PnMagalhaes/Levitation-Ball/Galery/IMG_20170502_105831.jpg

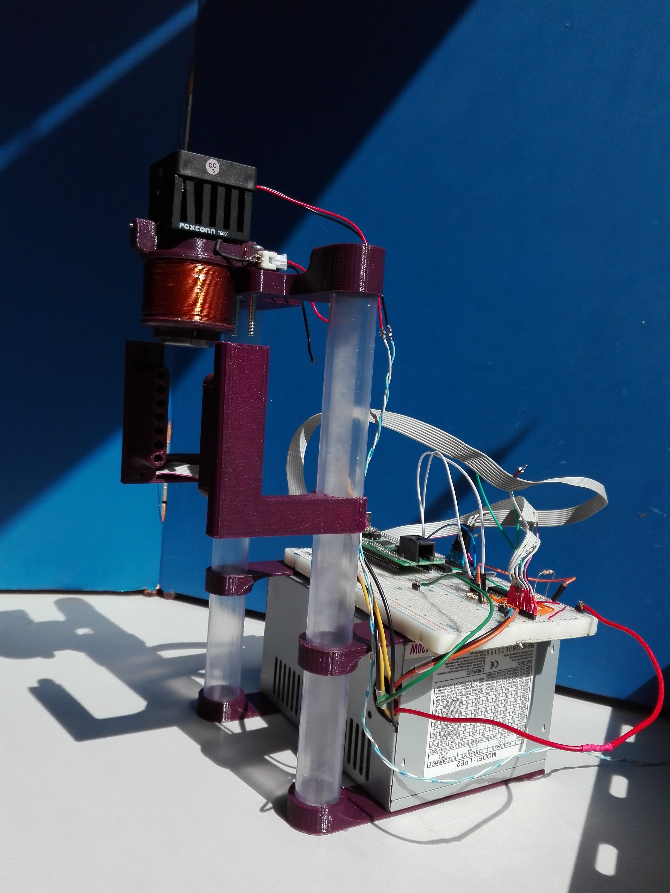
Galery/IMG_20170502_105831.jpg
