PnMagalhaes/Levitation-Ball/Galery/IMG_20170501_231723.jpg

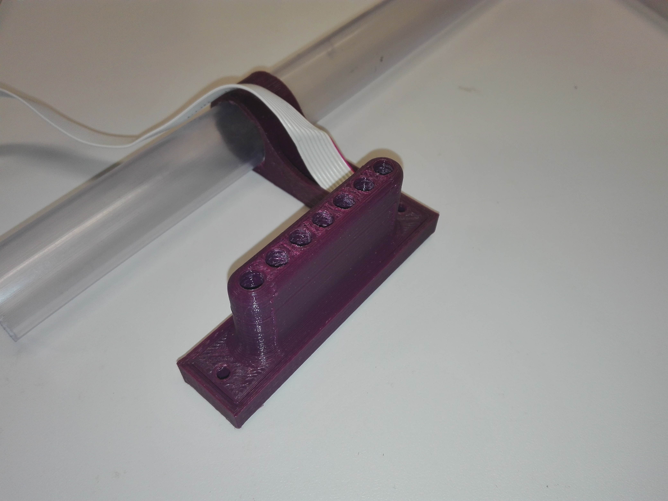
Galery/IMG_20170501_231723.jpg
