PnMagalhaes/Levitation-Ball/Circuits/Regulador/LinksImportantes.docx

http://photonics.engr.uga.edu/controls/levitator_assignment.pdf

http://web.mit.edu/6.302/www/maglev.pdf

https://mekonik.wordpress.com/2009/03/17/arduino-magnet-levitation/

http://www.onmyphd.com/?p=voltage.regulators.linear.series
