PnMagalhaes/Levitation-Ball/Circuits/Regulador/ChargePump.PNG

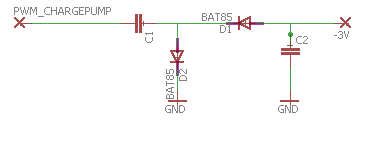
Circuits/Regulador/ChargePump.PNG
