PnMagalhaes/Levitation-Ball/Circuits/Regulador/weird stuff.JPG

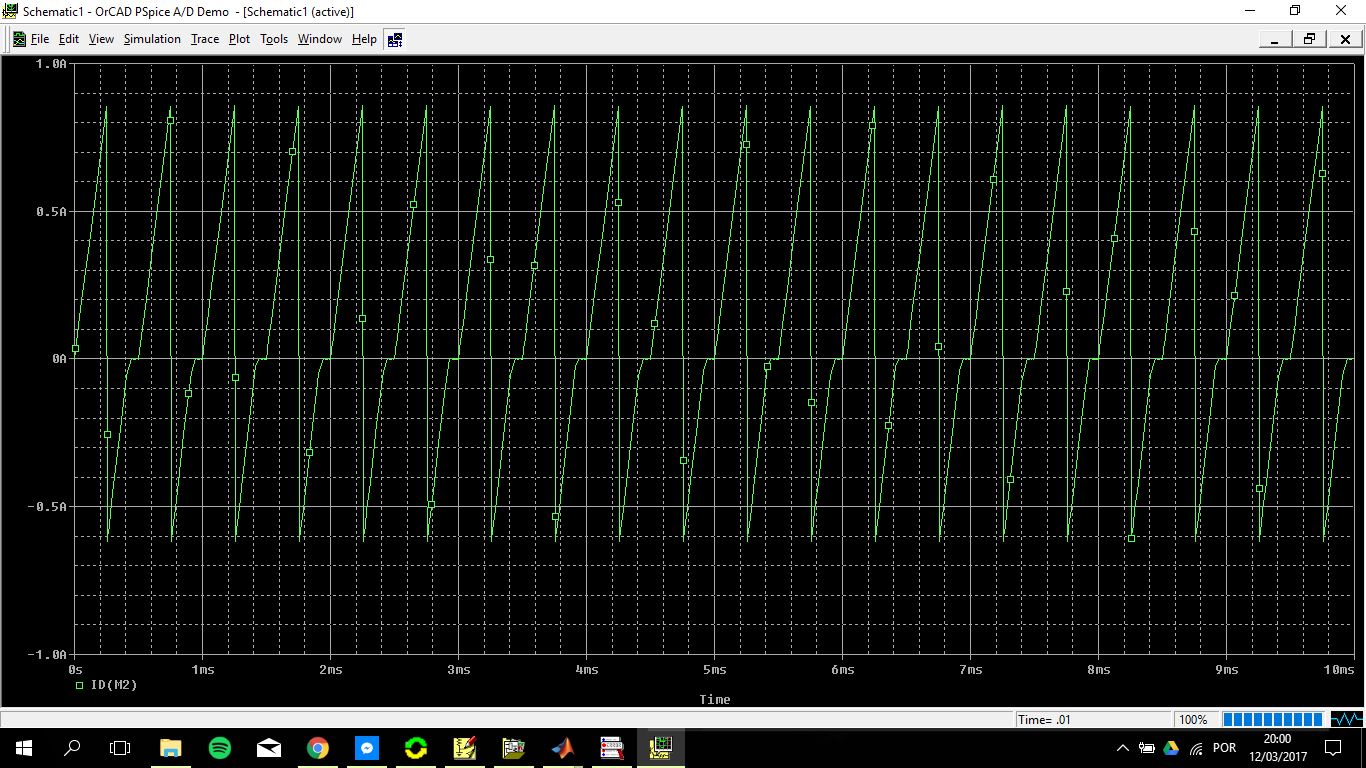
Circuits/Regulador/weird stuff.JPG
