PnMagalhaes/Levitation-Ball/Circuits/Sensores/emissoresIR.PNG

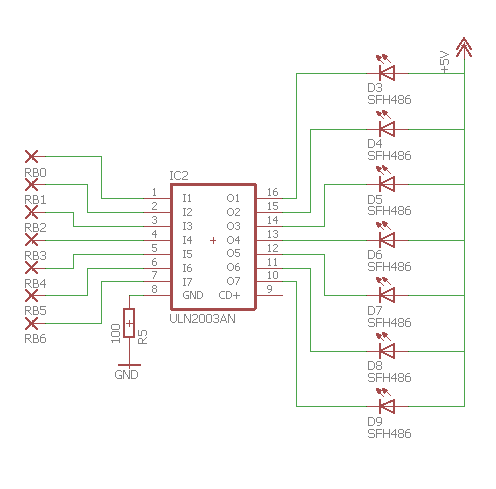
Circuits/Sensores/emissoresIR.PNG
