PnMagalhaes/Levitation-Ball/Documentation/PERT Diagram Example 1 - New Page.png

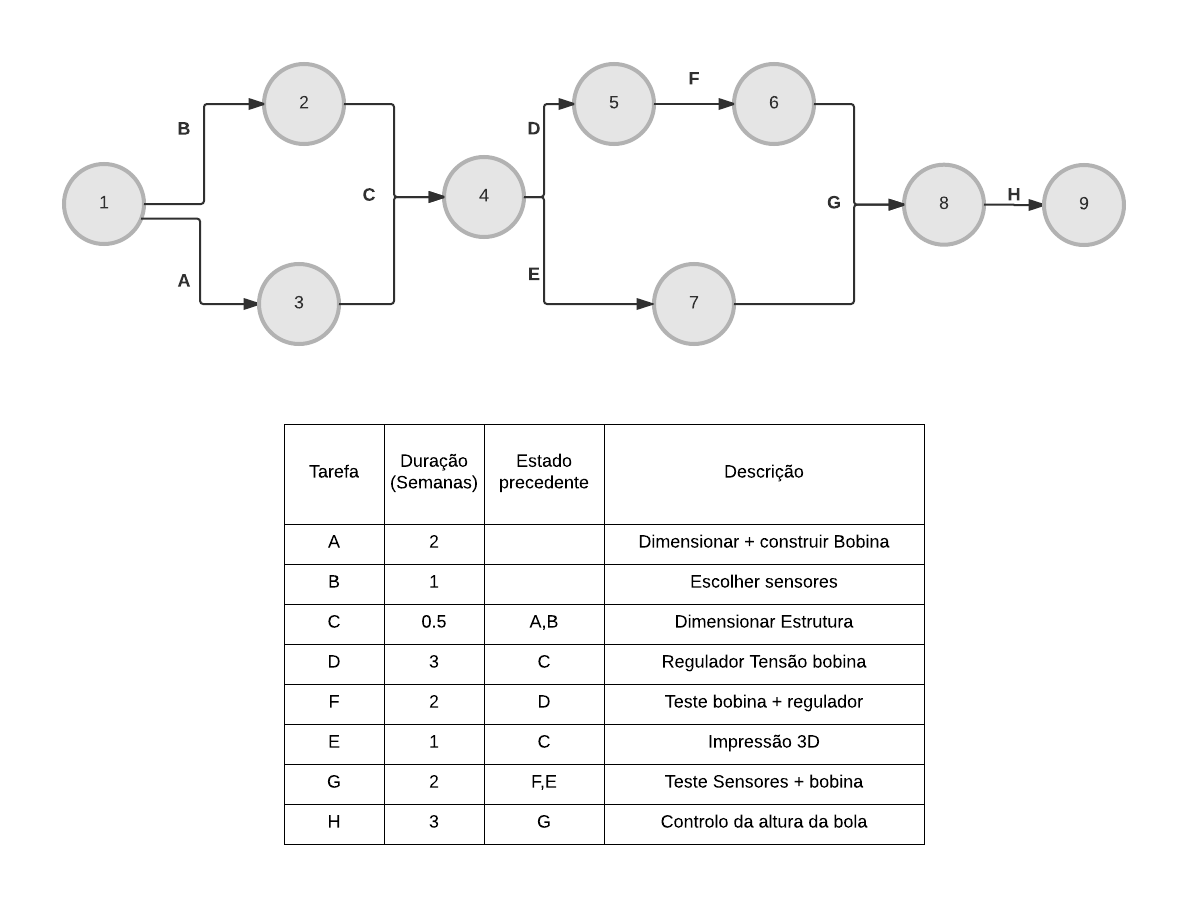
Documentation/PERT Diagram Example 1 - New Page.png
