PnMagalhaes/Levitation-Ball/Galery/20170320_143558.jpg

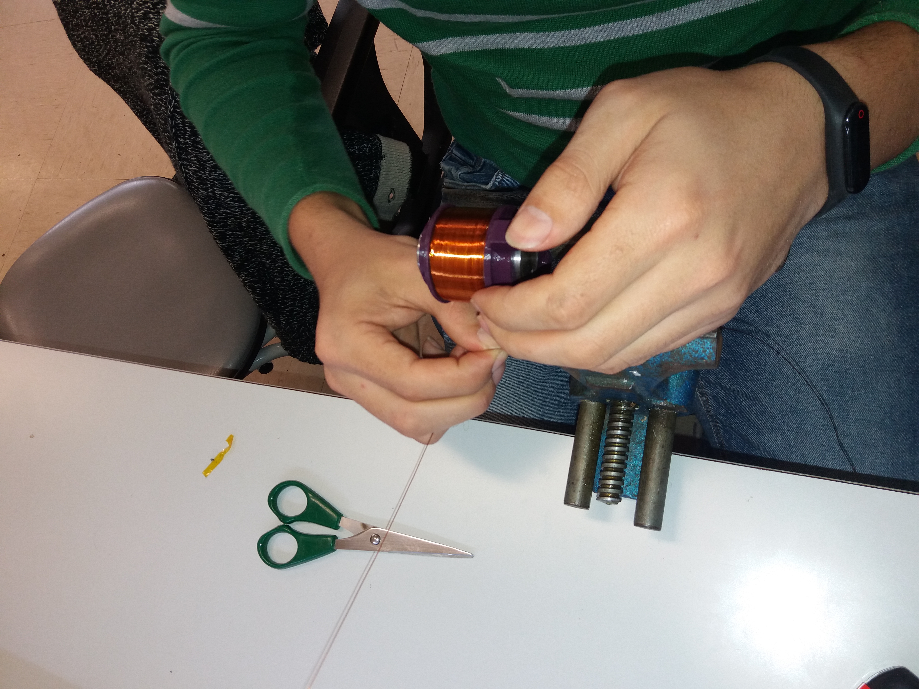
Galery/20170320_143558.jpg
