PnMagalhaes/Levitation-Ball/Galery/20170320_180035.jpg

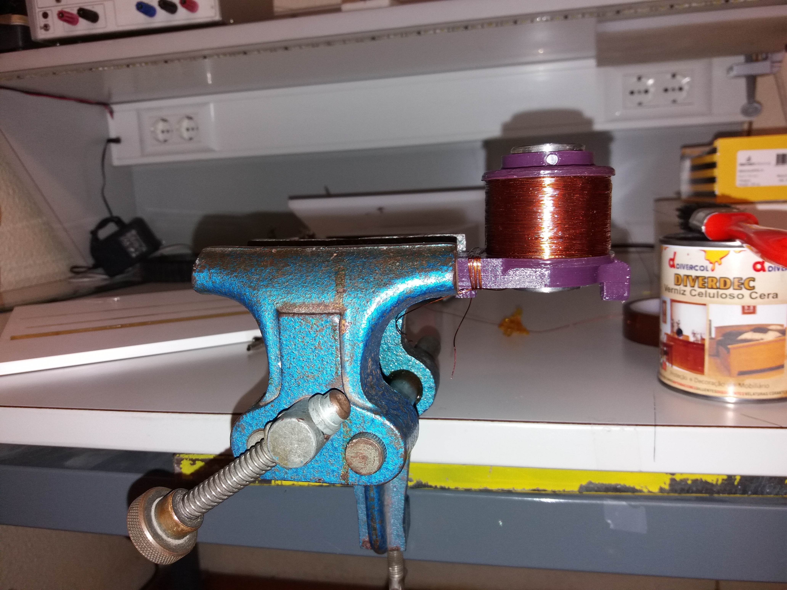
Galery/20170320_180035.jpg
