PnMagalhaes/Levitation-Ball/Galery/IMG_20170501_231756.jpg

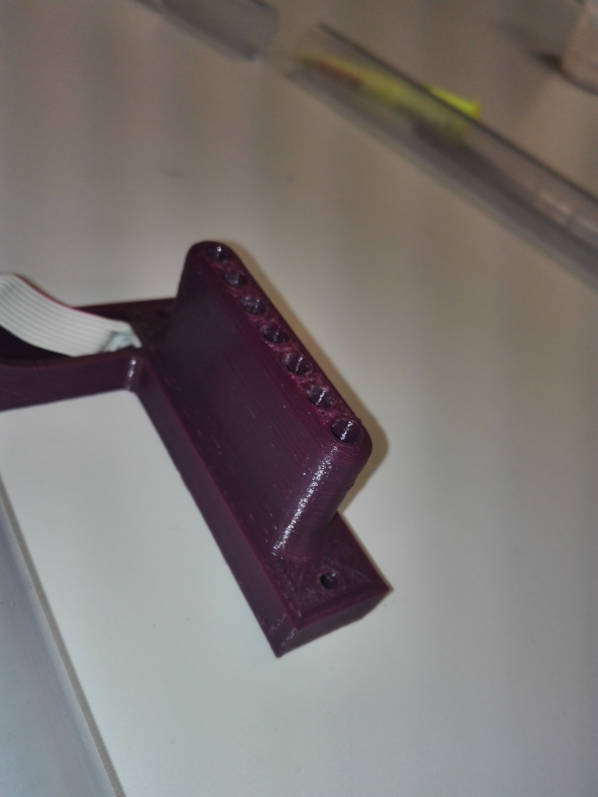
Galery/IMG_20170501_231756.jpg
