PnMagalhaes/Levitation-Ball/Galery/IMG_20170501_232402.jpg

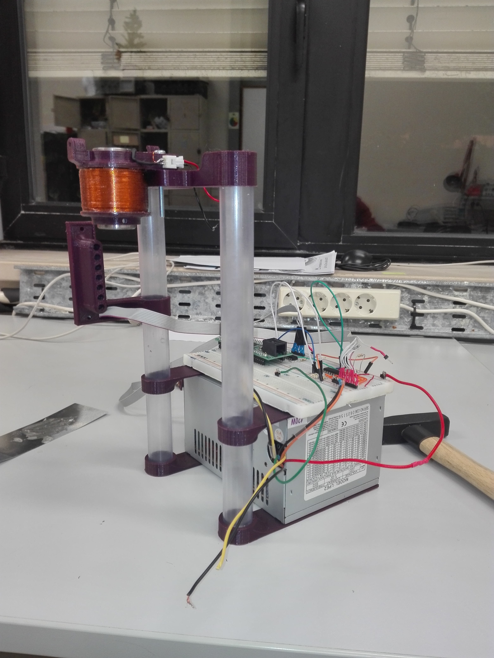
Galery/IMG_20170501_232402.jpg
