PnMagalhaes/Levitation-Ball/Galery/IMG_20170501_232730.jpg

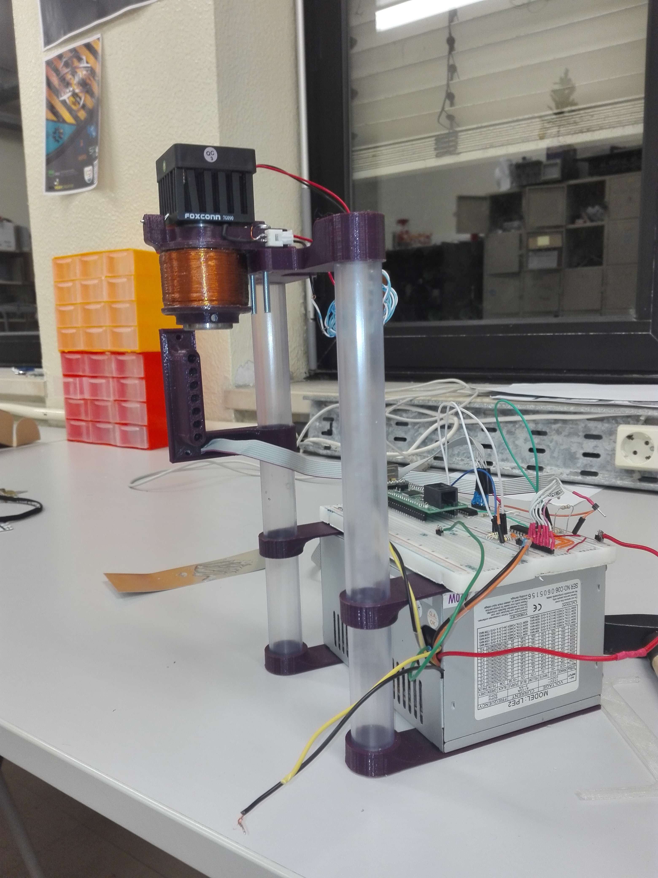
Galery/IMG_20170501_232730.jpg
