PnMagalhaes/Levitation-Ball/Galery/IMG_20170502_105451.jpg

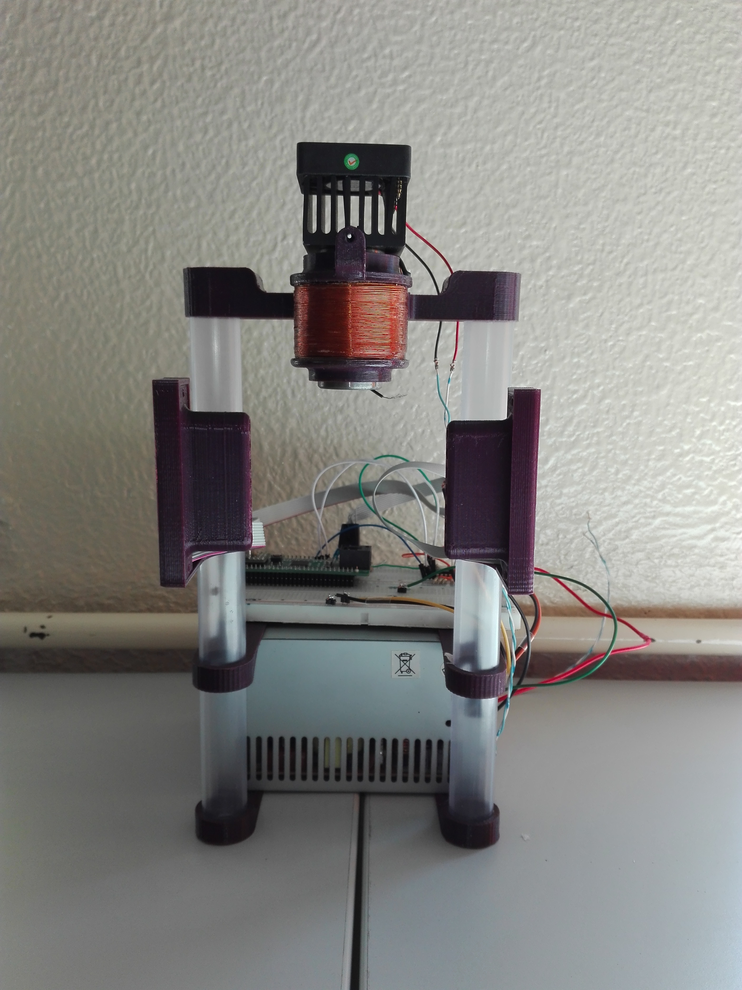
Galery/IMG_20170502_105451.jpg
