PnMagalhaes/Levitation-Ball/Galery/IMG_20170502_105531.jpg

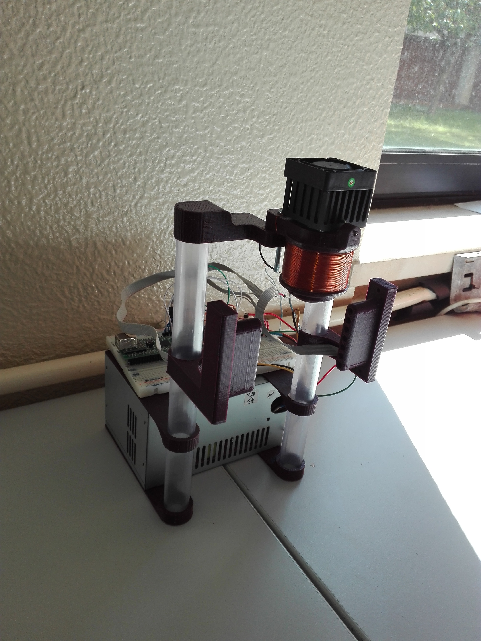
Galery/IMG_20170502_105531.jpg
