PnMagalhaes/Levitation-Ball/Galery/IMG_20170502_105553.jpg

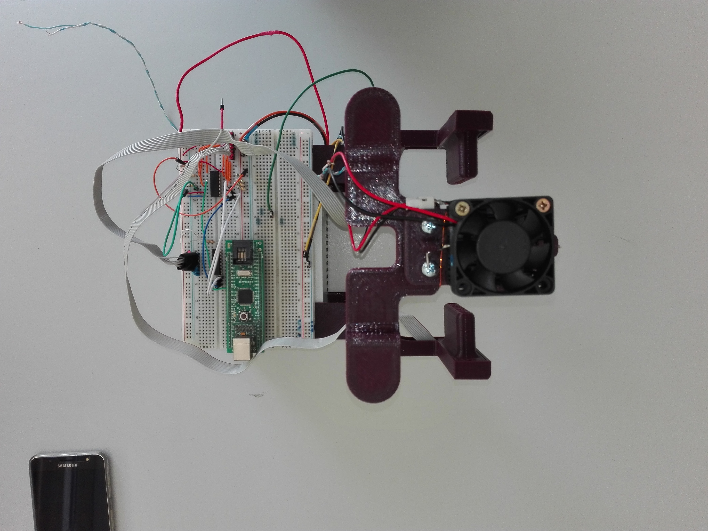
Galery/IMG_20170502_105553.jpg
