PnMagalhaes/Levitation-Ball/Galery/IMG_20170502_105650.jpg

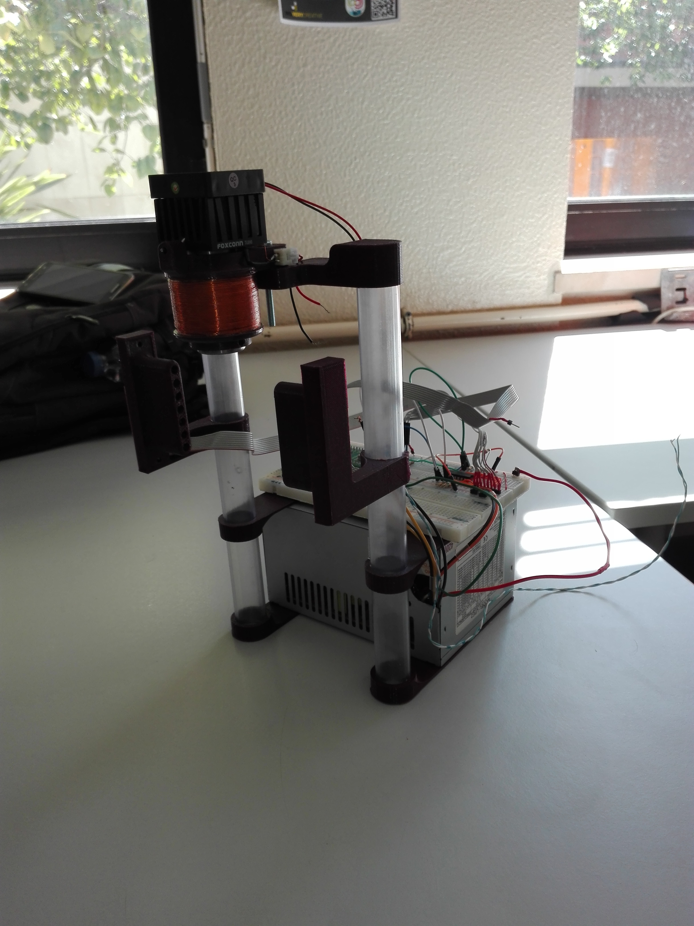
Galery/IMG_20170502_105650.jpg
