PnMagalhaes/Levitation-Ball/Galery/IMG_20170502_105702.jpg

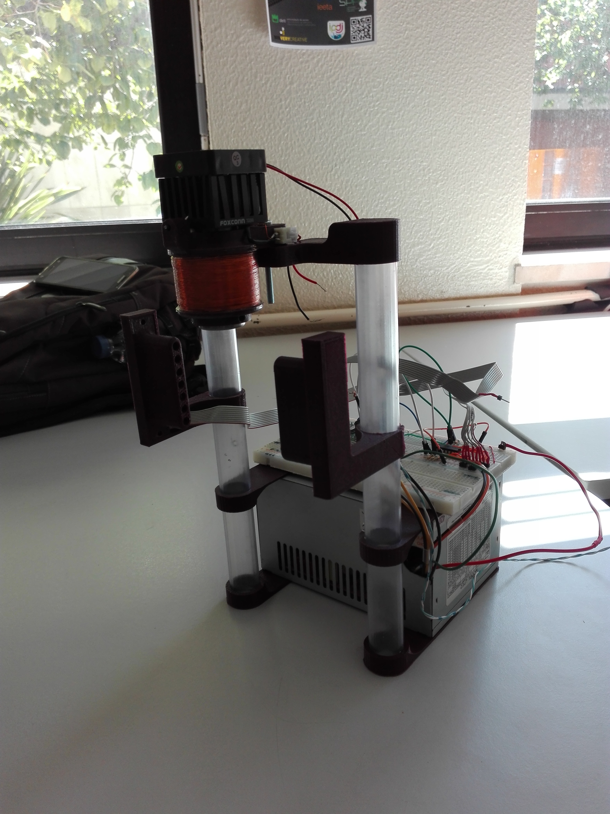
Galery/IMG_20170502_105702.jpg
