PnMagalhaes/Levitation-Ball/Simulation/EMS SW/New folder/Assem3.SLDASM

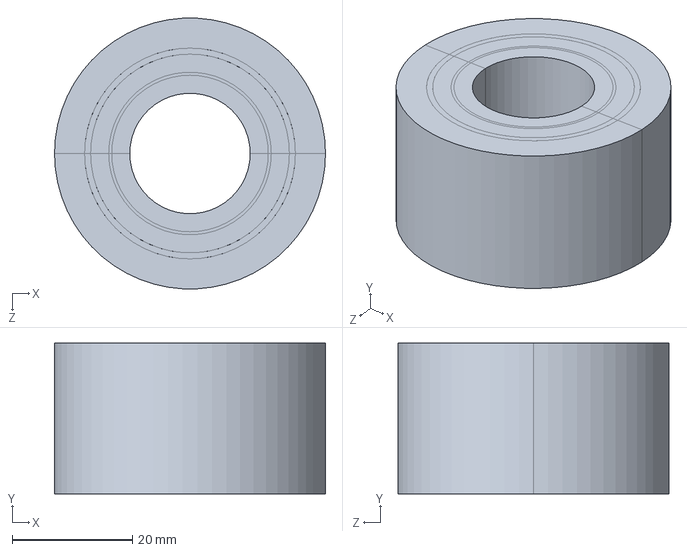
[picture p33: CAD file, 2017-05-07]
Simulation/EMS SW/New folder/Assem3.SLDASM
45.0 x 25.0 x 44.9 mm
partBobina x 2
