PnMagalhaes/Levitation-Ball/Simulation/EMS SW/half/Assem1.SLDASM

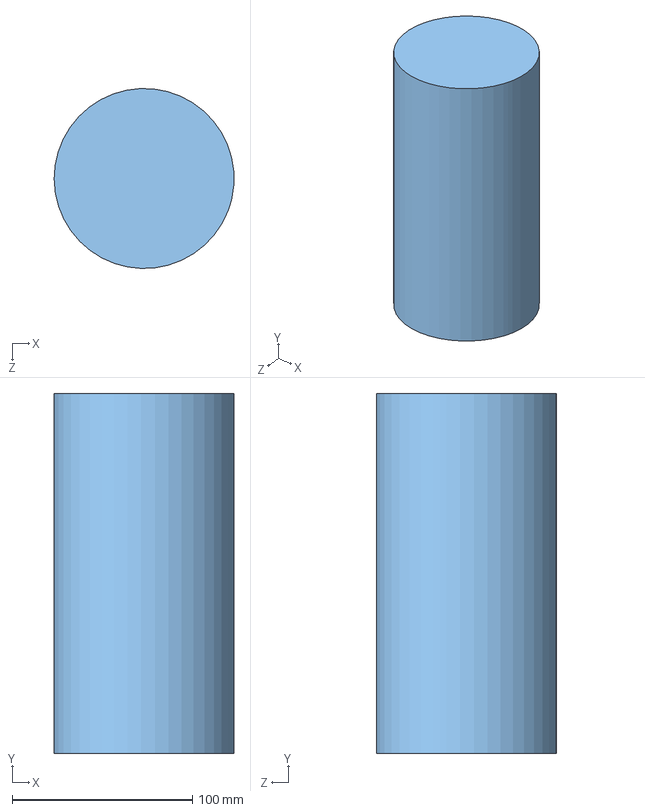
[picture p34: CAD file, 2017-05-07]
Simulation/EMS SW/half/Assem1.SLDASM
99.9 x 200.0 x 99.9 mm
coil
Nucleo
mass
arGap
