PnMagalhaes/Levitation-Ball/Simulation/EMS SW/New folder/Assem2.SLDASM

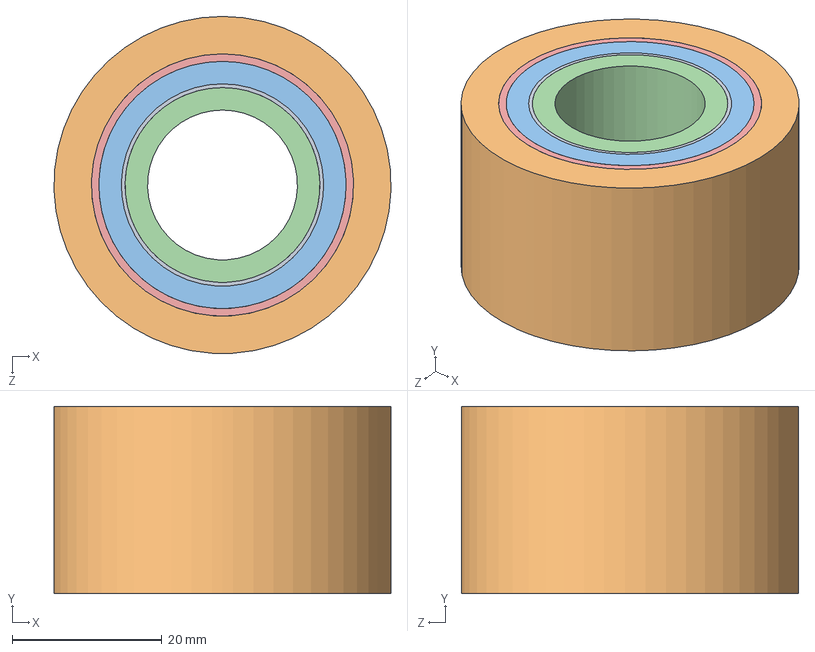
[picture p35: CAD file, 2017-05-07]
Simulation/EMS SW/New folder/Assem2.SLDASM
45.0 x 25.0 x 45.0 mm
A1
c3
c2
c1
a2
