PnMagalhaes/Levitation-Ball/3D models/SolidWorks/Assem2.SLDASM

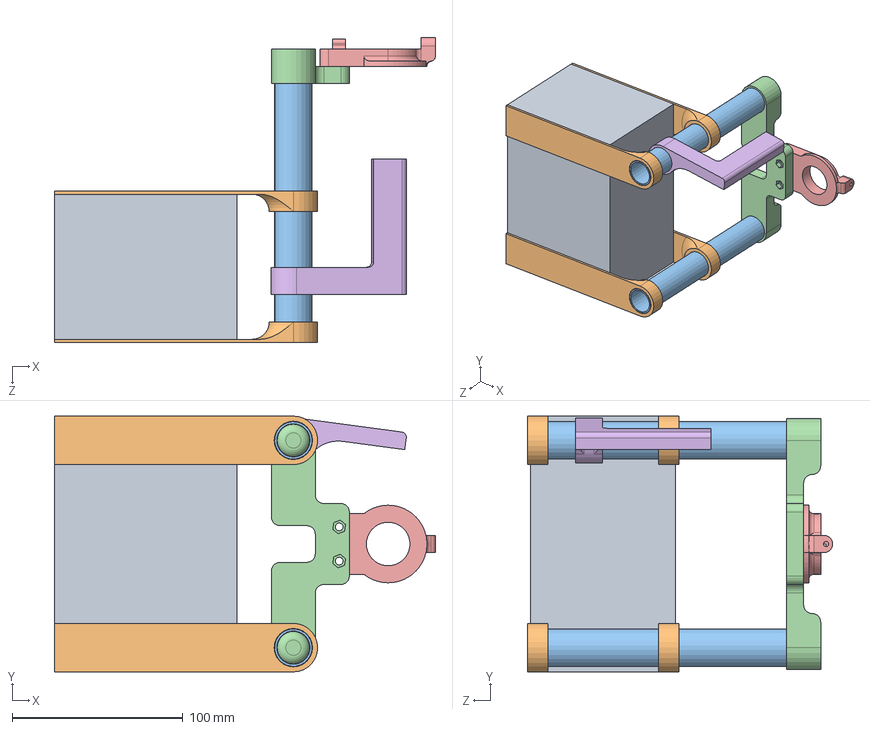
[picture p36: CAD file, 2017-05-07]
3D models/SolidWorks/Assem2.SLDASM
223.3 x 150.0 x 179.0 mm
fonte
Patinha x 4
tubo x 2
top
Dissipador
sensores2
