PnMagalhaes/Levitation-Ball/Simulation/EMS SW/half/Assem2.SLDASM

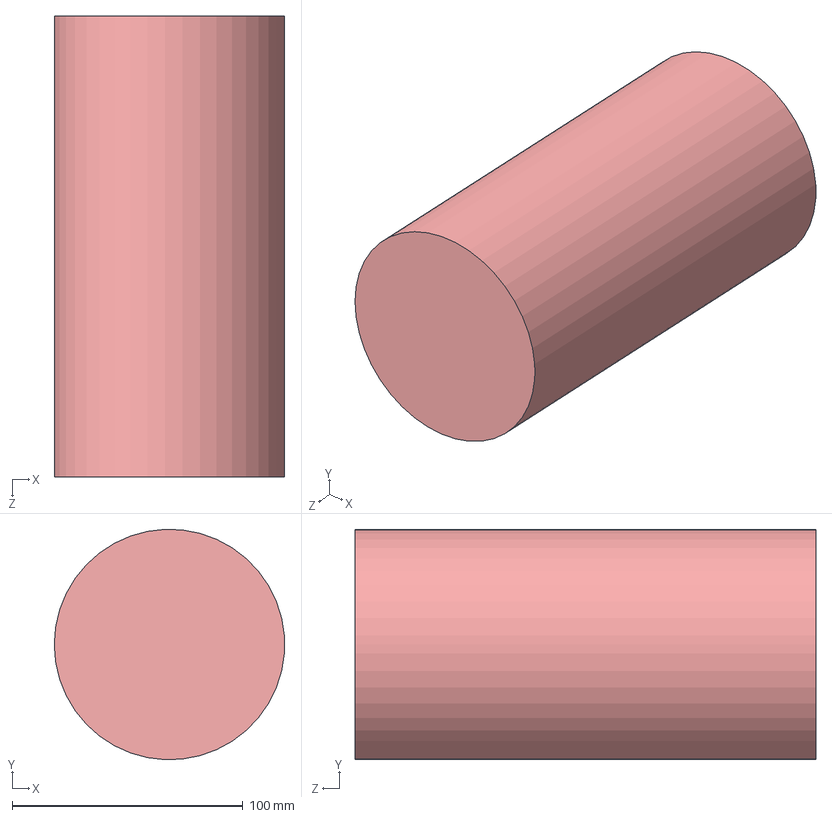
[picture p37: CAD file, 2017-05-07]
Simulation/EMS SW/half/Assem2.SLDASM
100.0 x 99.9 x 200.0 mm
coilh
arGap
mass
Nucleo
