PnMagalhaes/Levitation-Ball/Simulation/EMS SW/Assem4.SLDASM

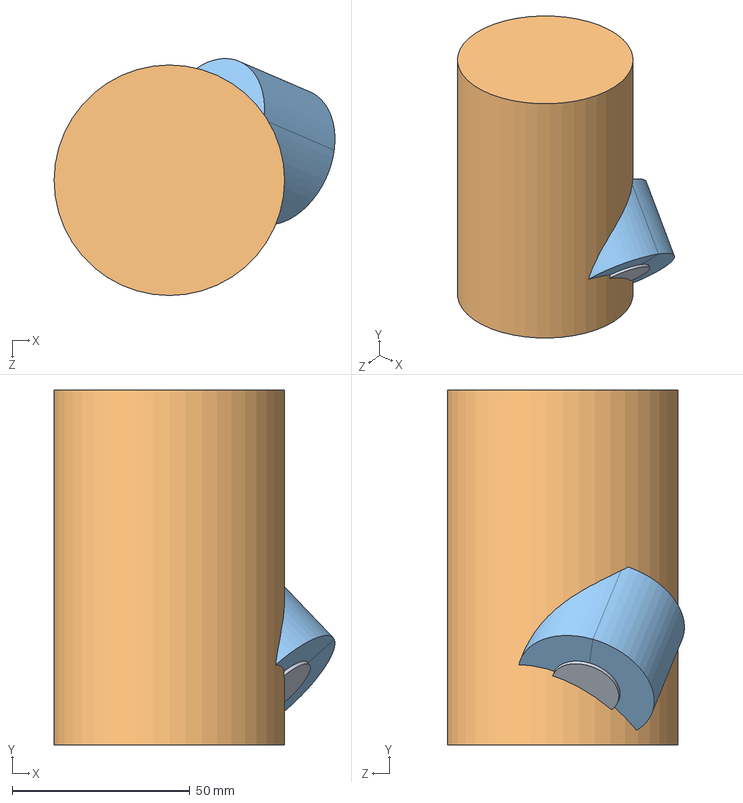
[picture p38: CAD file, 2017-05-07]
Simulation/EMS SW/Assem4.SLDASM
79.1 x 100.0 x 66.8 mm
Nucleo
coil
in_Air
