PnMagalhaes/Levitation-Ball/Simulation/EMS SW/Assem3.SLDASM

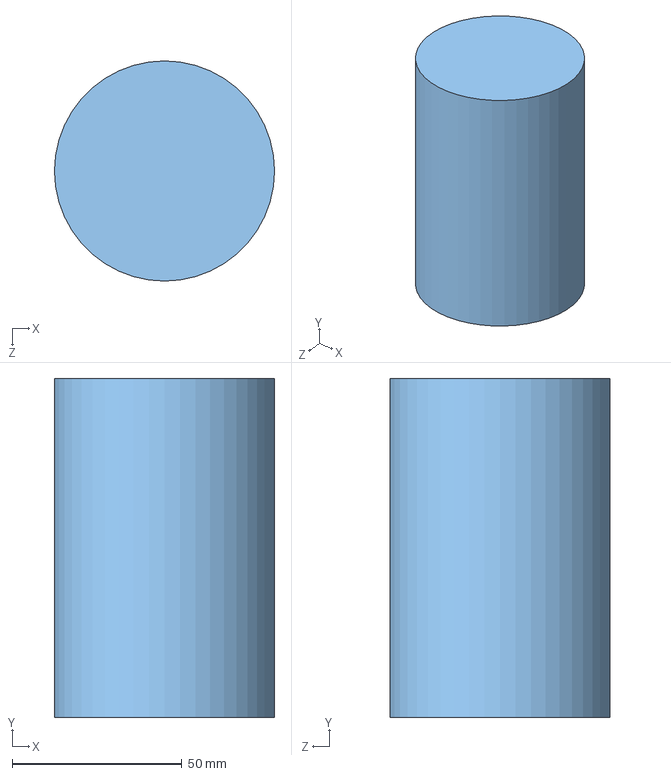
[picture p39: CAD file, 2017-05-07]
Simulation/EMS SW/Assem3.SLDASM
64.9 x 100.0 x 64.9 mm
coil
Nucleo
