PnMagalhaes/Levitation-Ball/Simulation/EMS SW/Assem2.SLDASM

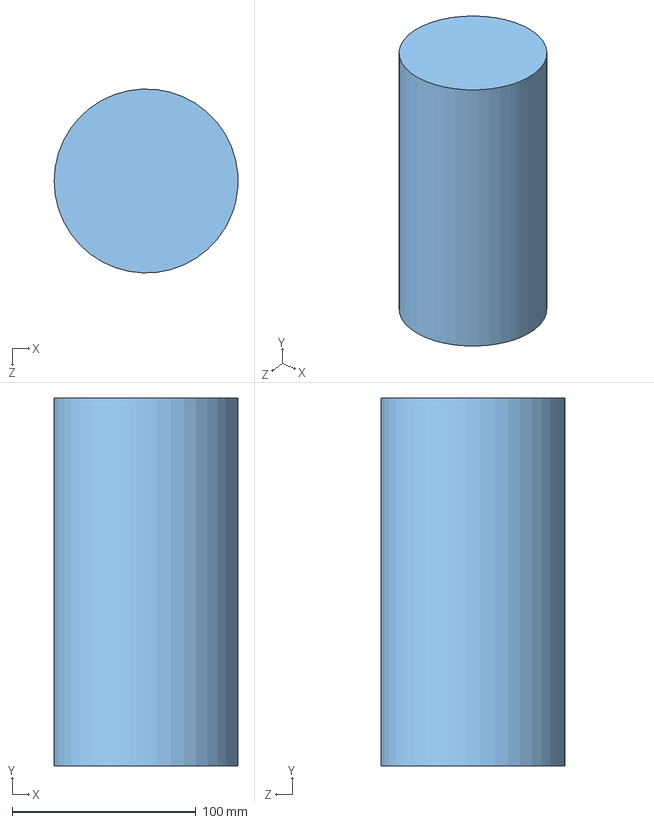
[picture p40: CAD file, 2017-05-07]
Simulation/EMS SW/Assem2.SLDASM
99.9 x 200.0 x 99.9 mm
coil
Nucleo
in_Air
