PnMagalhaes/Levitation-Ball/3D models/SolidWorks/anilha_baixo.SLDPRT

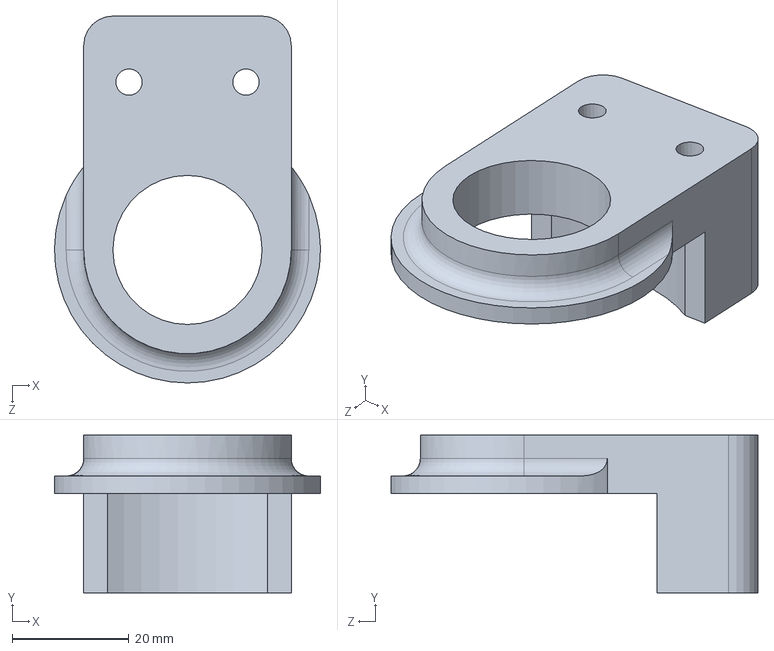
[picture p41: CAD file, 2017-05-09]
3D models/SolidWorks/anilha_baixo.SLDPRT
45.5 x 27.0 x 62.8 mm
