PnMagalhaes/Levitation-Ball/Simulation/EMS SW/half/coilh.SLDPRT

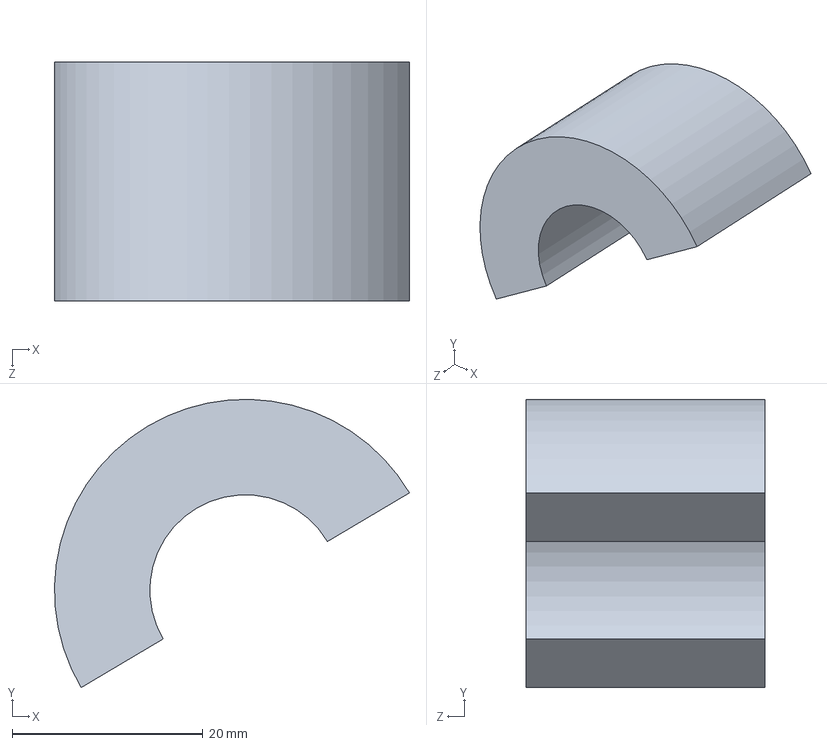
[picture p42: CAD file, 2017-05-07]
Simulation/EMS SW/half/coilh.SLDPRT
37.2 x 30.2 x 25.0 mm
