PnMagalhaes/Levitation-Ball/Simulation/EMS SW/New folder/A1.SLDPRT

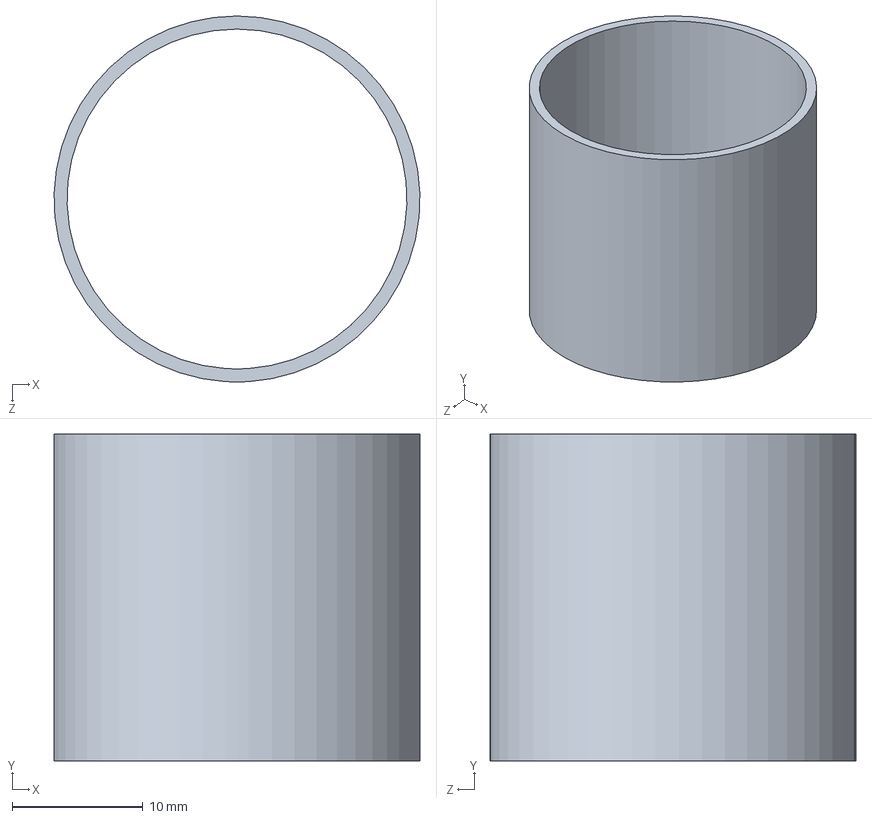
[picture p43: CAD file, 2017-05-07]
Simulation/EMS SW/New folder/A1.SLDPRT
28.0 x 25.0 x 28.0 mm
