PnMagalhaes/Levitation-Ball/Simulation/EMS SW/tape4.SLDPRT

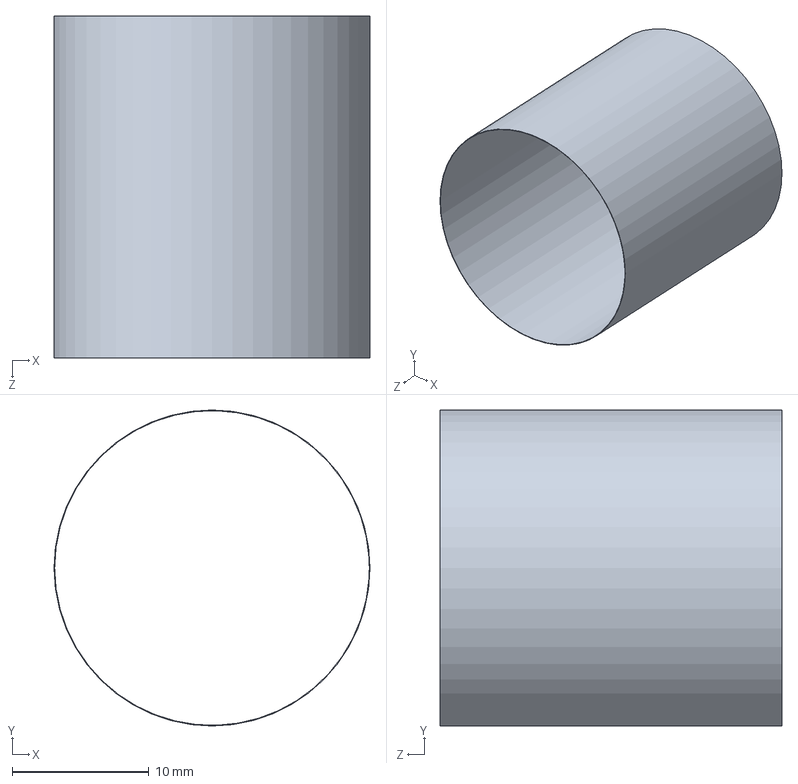
[picture p44: CAD file, 2017-05-07]
Simulation/EMS SW/tape4.SLDPRT
23.1 x 23.1 x 25.0 mm
