PnMagalhaes/Levitation-Ball/3D models/SolidWorks/sensores2.SLDPRT

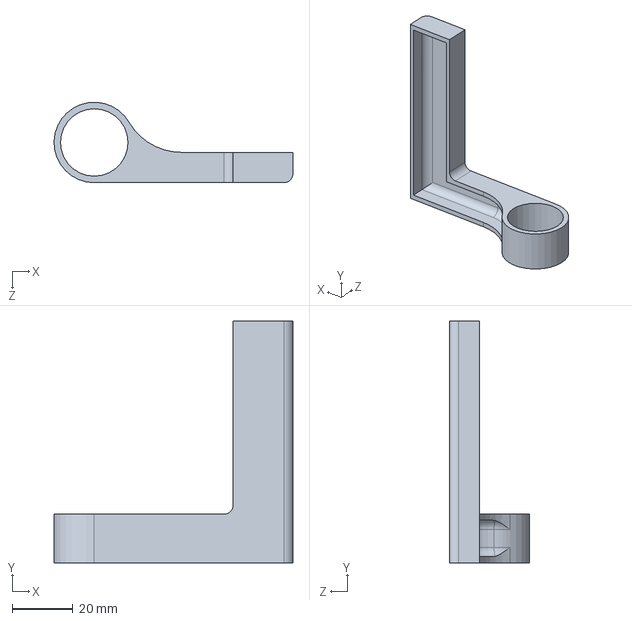
[picture p45: CAD file, 2017-05-07]
3D models/SolidWorks/sensores2.SLDPRT
78.7 x 79.5 x 26.5 mm
