PnMagalhaes/Levitation-Ball/3D models/STL-To print/top.STL

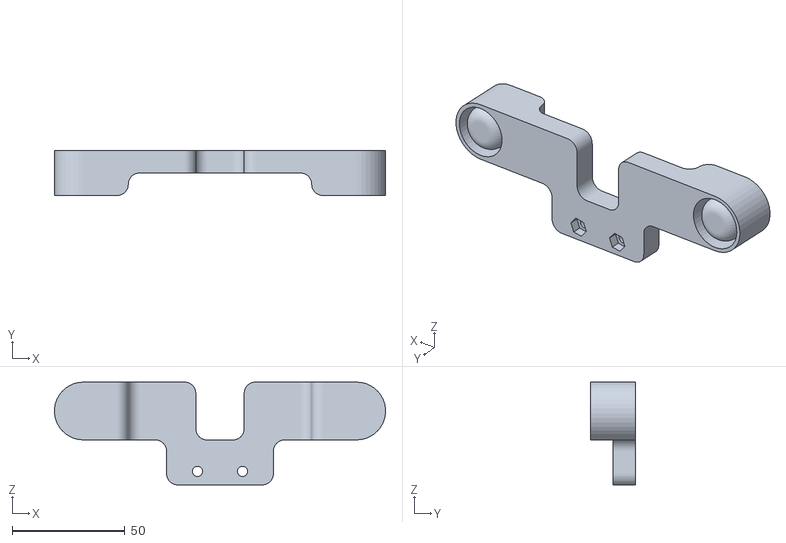
[picture p46: CAD file, 2017-05-07]
3D models/STL-To print/top.STL
147.1 x 20.0 x 45.7
