PnMagalhaes/Levitation-Ball/Simulation/EMS SW/half/arGap.SLDPRT

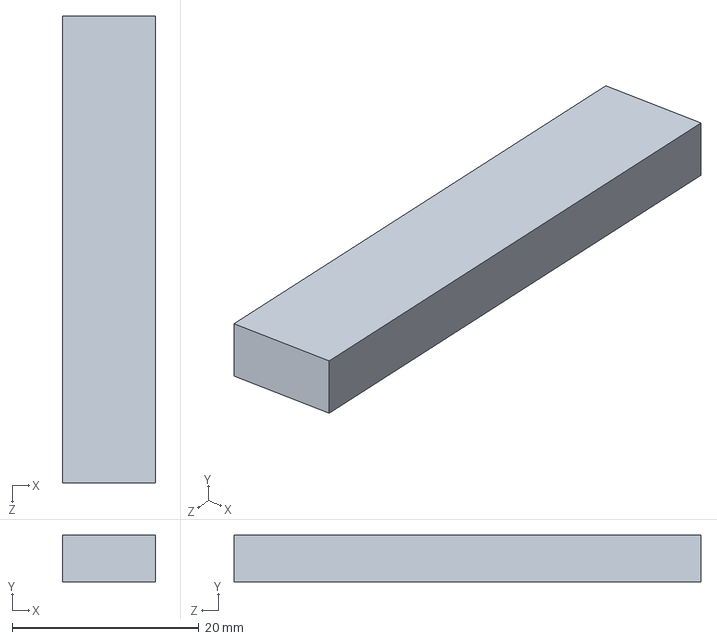
[picture p47: CAD file, 2017-05-07]
Simulation/EMS SW/half/arGap.SLDPRT
10.0 x 5.00 x 50.0 mm
