PnMagalhaes/Levitation-Ball/Simulation/EMS SW/tape6.SLDPRT

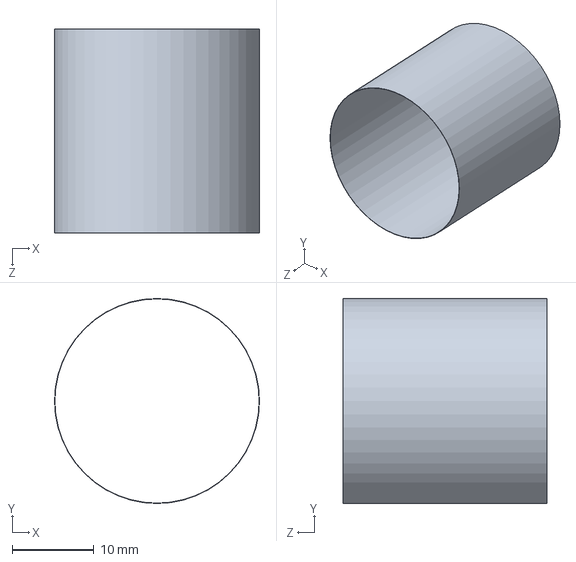
[picture p48: CAD file, 2017-05-07]
Simulation/EMS SW/tape6.SLDPRT
25.1 x 25.1 x 25.0 mm
