PnMagalhaes/Levitation-Ball/3D models/STL-To print/Patinha.STL

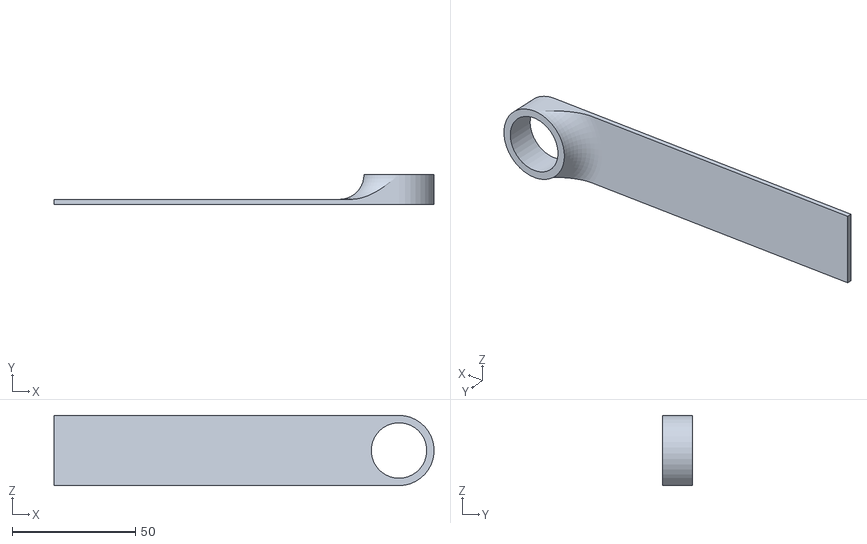
[picture p49: CAD file, 2017-05-07]
3D models/STL-To print/Patinha.STL
154.2 x 12.0 x 28.5
