PnMagalhaes/Levitation-Ball/Simulation/EMS SW/New folder/partBobina.SLDPRT

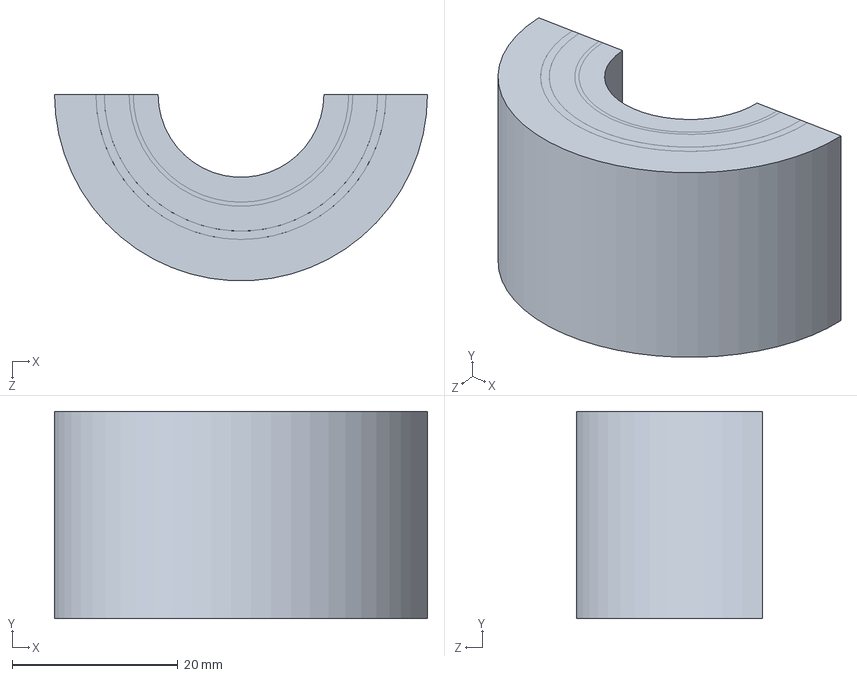
[picture p50: CAD file, 2017-05-07]
Simulation/EMS SW/New folder/partBobina.SLDPRT
45.0 x 25.0 x 22.5 mm
