PnMagalhaes/Levitation-Ball/Simulation/EMS SW/tape10.SLDPRT

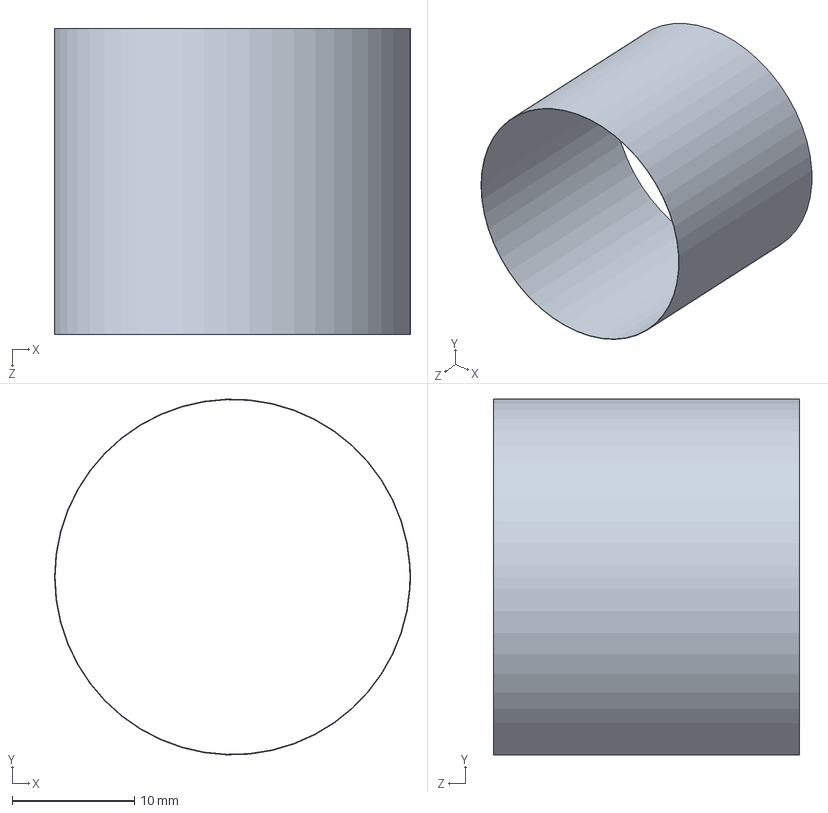
[picture p51: CAD file, 2017-05-07]
Simulation/EMS SW/tape10.SLDPRT
29.1 x 29.1 x 25.0 mm
