PnMagalhaes/Levitation-Ball/Simulation/EMS SW/coil.SLDPRT

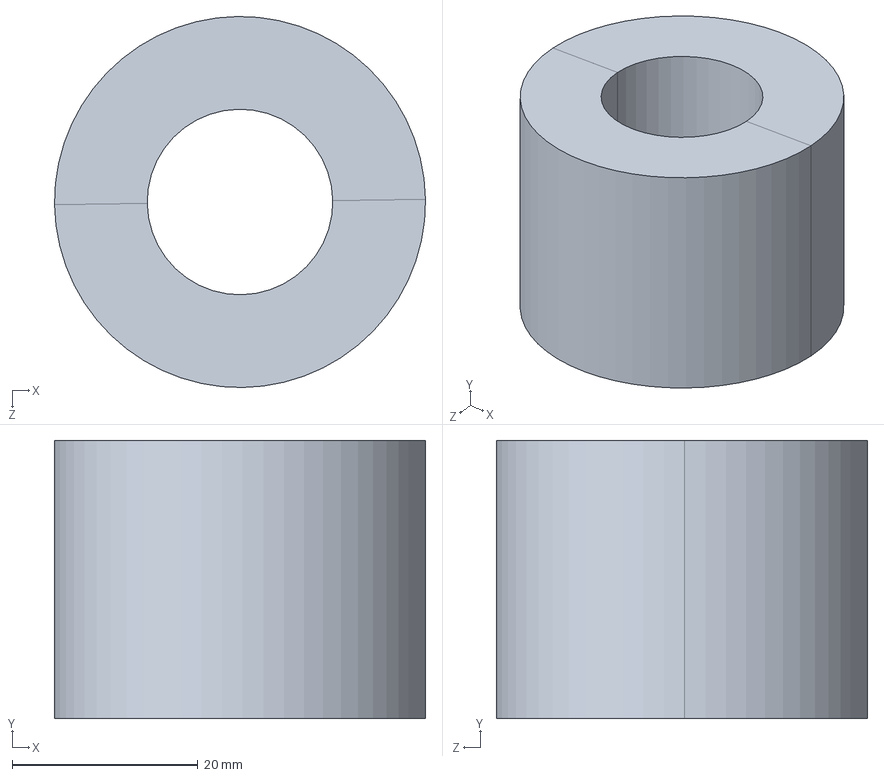
[picture p52: CAD file, 2017-05-07]
Simulation/EMS SW/coil.SLDPRT
40.0 x 30.0 x 40.0 mm
