PnMagalhaes/Levitation-Ball/Simulation/EMS SW/half/Nucleo.SLDPRT

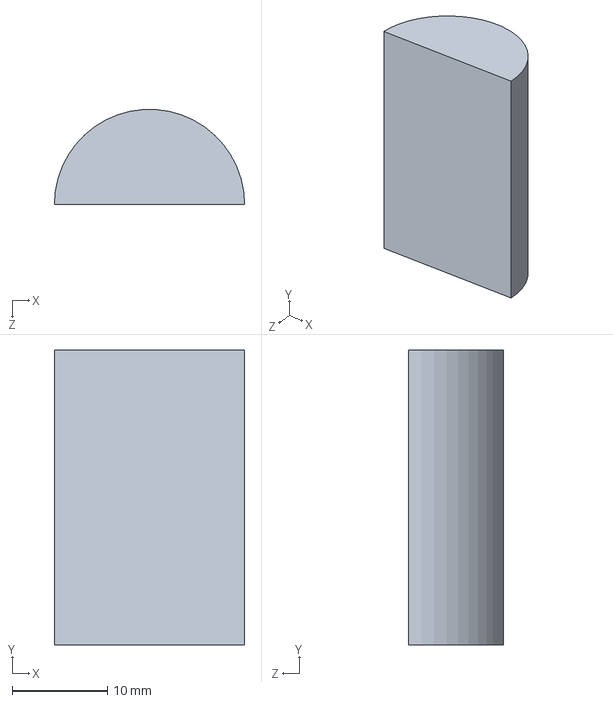
[picture p53: CAD file, 2017-05-07]
Simulation/EMS SW/half/Nucleo.SLDPRT
20.0 x 31.0 x 9.98 mm
