PnMagalhaes/Levitation-Ball/Simulation/EMS SW/mass.SLDPRT

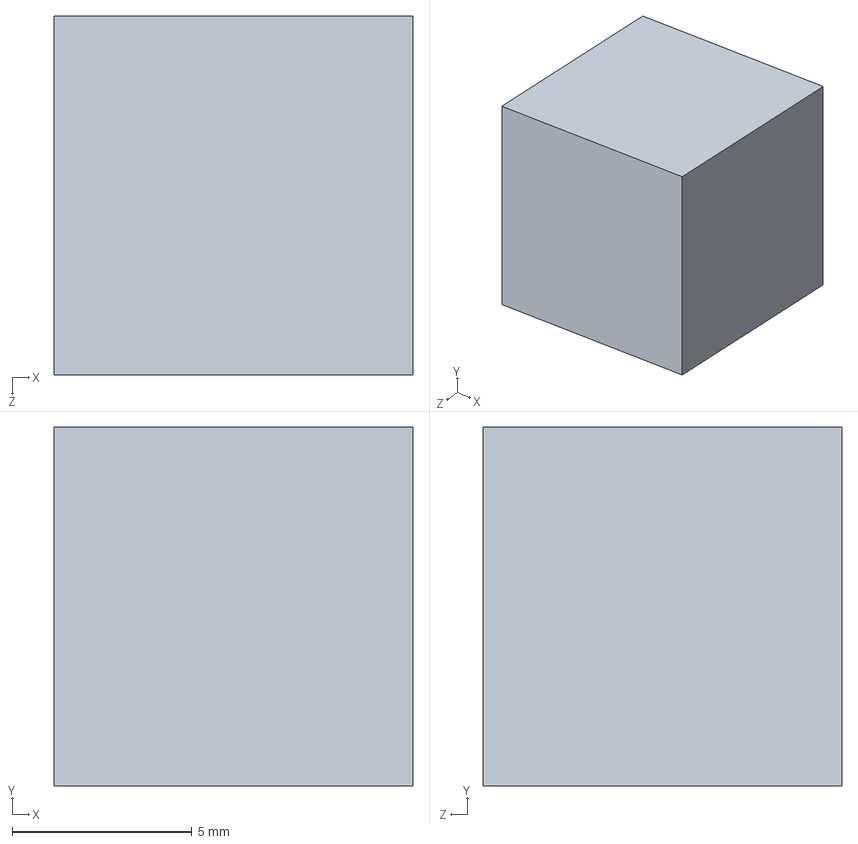
[picture p54: CAD file, 2017-05-07]
Simulation/EMS SW/mass.SLDPRT
10.0 x 10.0 x 10.0 mm
