PnMagalhaes/Levitation-Ball/Simulation/EMS SW/New folder/a2.SLDPRT

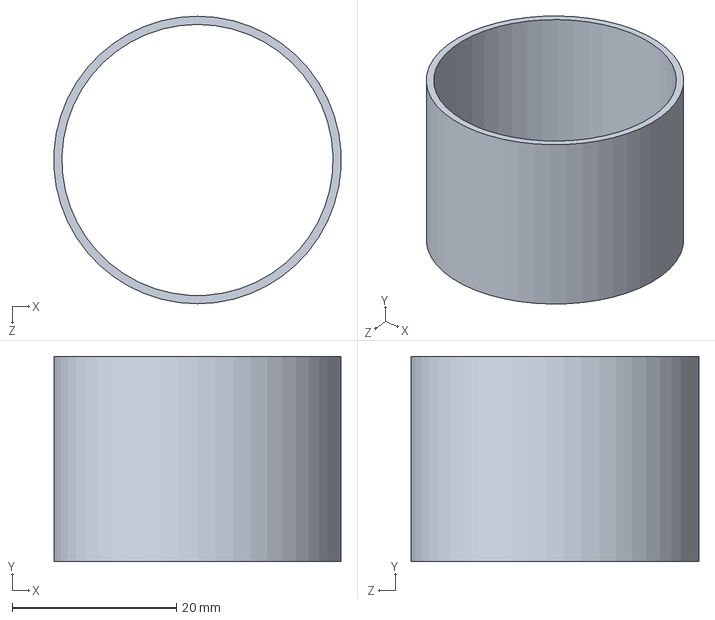
[picture p55: CAD file, 2017-05-07]
Simulation/EMS SW/New folder/a2.SLDPRT
34.9 x 25.0 x 35.0 mm
