PnMagalhaes/Levitation-Ball/Simulation/EMS SW/half/mass.SLDPRT

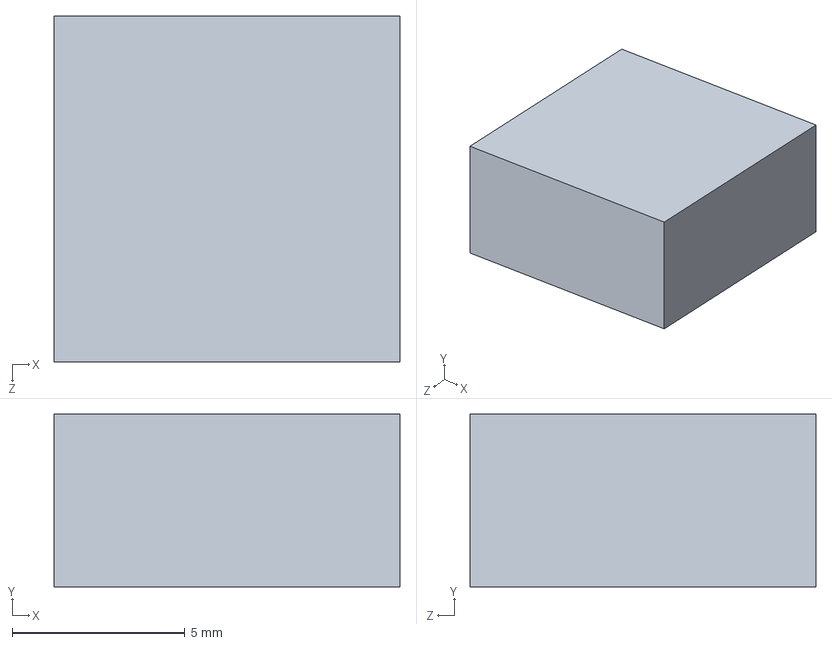
[picture p56: CAD file, 2017-05-07]
Simulation/EMS SW/half/mass.SLDPRT
10.0 x 5.00 x 10.0 mm
