PnMagalhaes/Levitation-Ball/Simulation/EMS SW/New folder/c2.SLDPRT

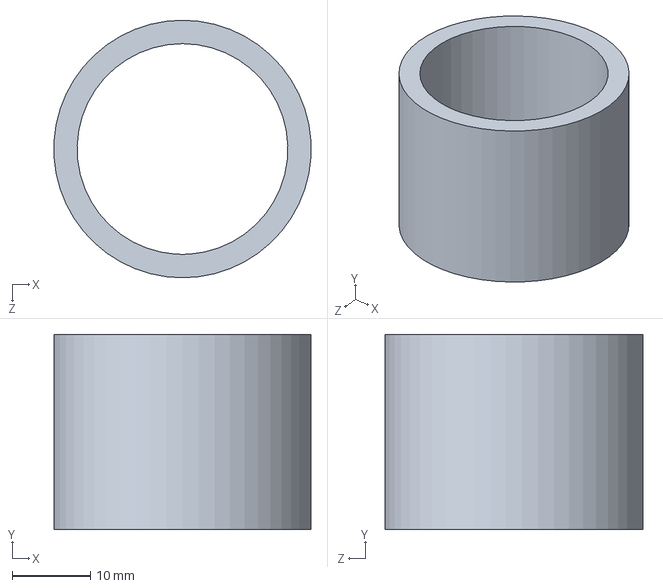
[picture p57: CAD file, 2017-05-07]
Simulation/EMS SW/New folder/c2.SLDPRT
32.9 x 25.0 x 33.0 mm
