PnMagalhaes/Levitation-Ball/Simulation/EMS SW/arGap.SLDPRT

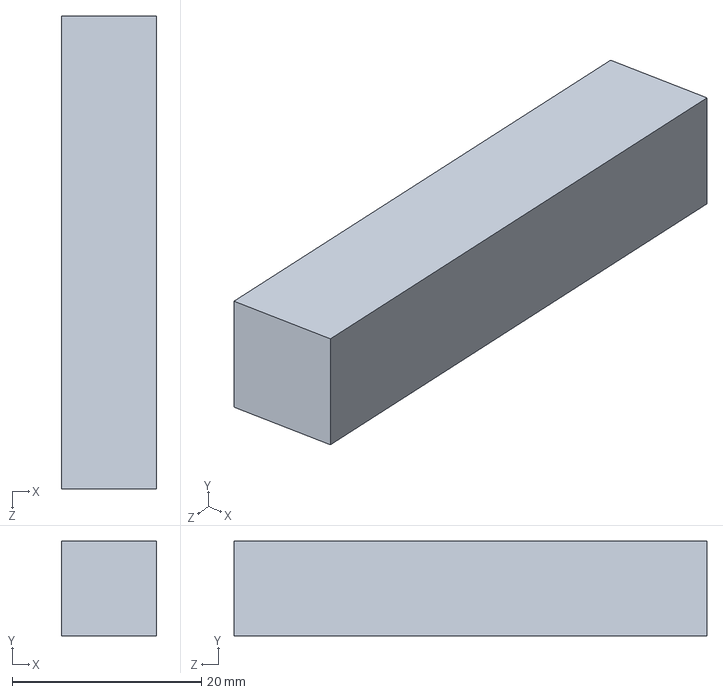
[picture p58: CAD file, 2017-05-07]
Simulation/EMS SW/arGap.SLDPRT
10.0 x 10.0 x 50.0 mm
