PnMagalhaes/Levitation-Ball/Simulation/EMS SW/half/coil.SLDPRT

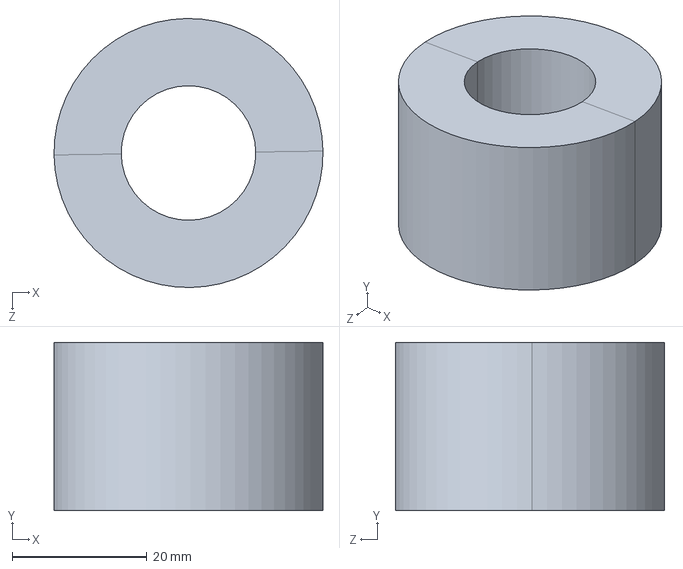
[picture p59: CAD file, 2017-05-07]
Simulation/EMS SW/half/coil.SLDPRT
40.0 x 25.0 x 40.0 mm
