PnMagalhaes/Levitation-Ball/Simulation/EMS SW/New folder/c1.SLDPRT

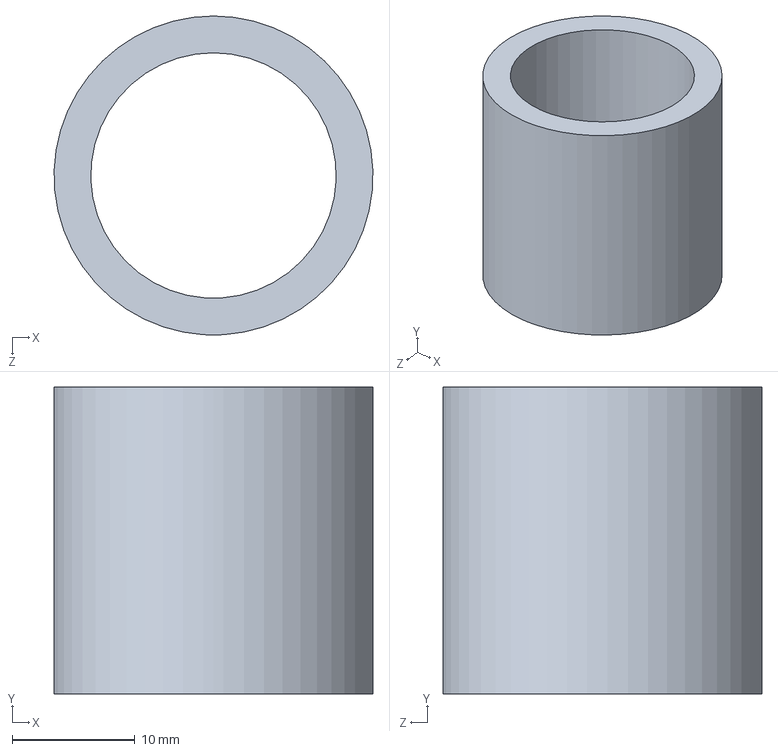
[picture p60: CAD file, 2017-05-07]
Simulation/EMS SW/New folder/c1.SLDPRT
26.0 x 25.0 x 26.0 mm
