PnMagalhaes/Levitation-Ball/Simulation/EMS SW/half/outerAir.SLDPRT

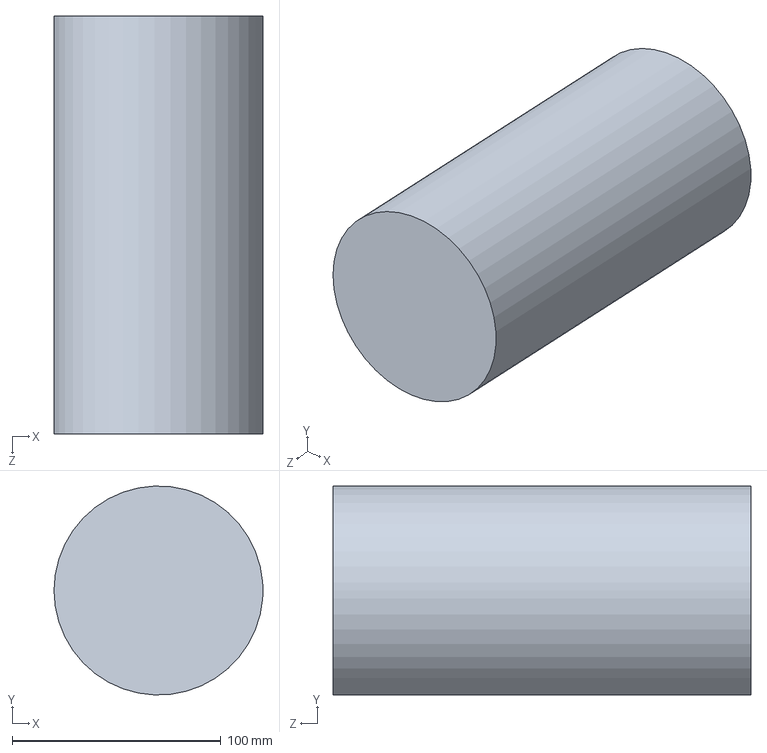
[picture p61: CAD file, 2017-05-07]
Simulation/EMS SW/half/outerAir.SLDPRT
100.0 x 99.9 x 200.0 mm
