PnMagalhaes/Levitation-Ball/Simulation/EMS SW/in_Air.SLDPRT

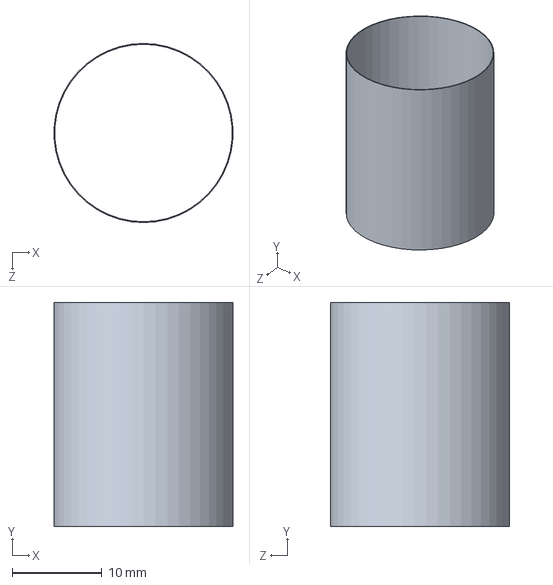
[picture p62: CAD file, 2017-05-07]
Simulation/EMS SW/in_Air.SLDPRT
20.0 x 25.0 x 20.0 mm
