PnMagalhaes/Levitation-Ball/Simulation/EMS SW/New folder/c3.SLDPRT

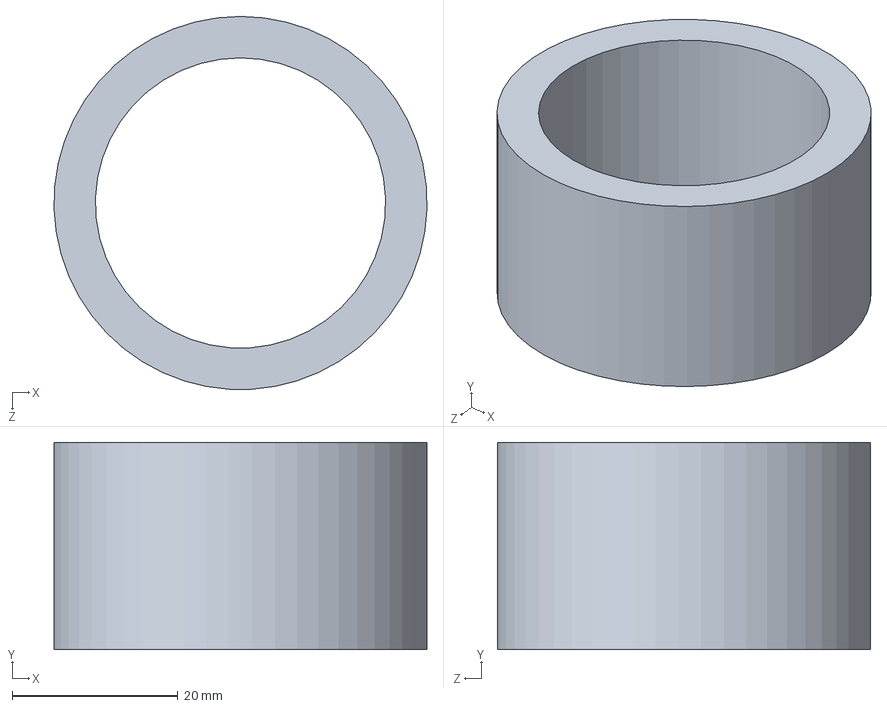
[picture p63: CAD file, 2017-05-07]
Simulation/EMS SW/New folder/c3.SLDPRT
45.0 x 25.0 x 45.0 mm
