PnMagalhaes/Levitation-Ball/Simulation/EMS SW/copper7.SLDPRT

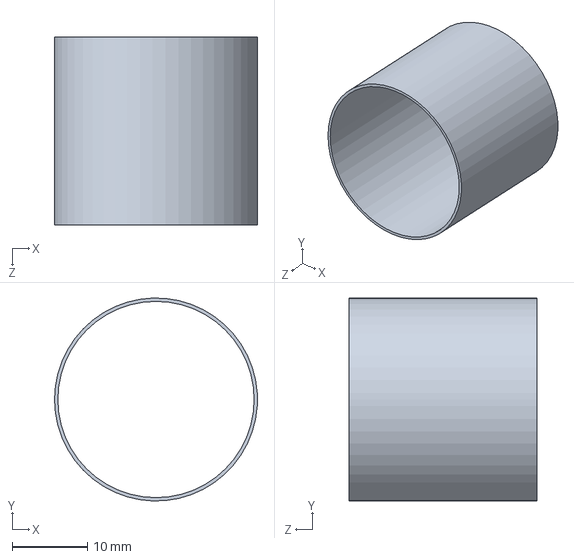
[picture p64: CAD file, 2017-05-07]
Simulation/EMS SW/copper7.SLDPRT
27.0 x 27.0 x 25.0 mm
