PnMagalhaes/Levitation-Ball/Simulation/EMS SW/tape5.SLDPRT

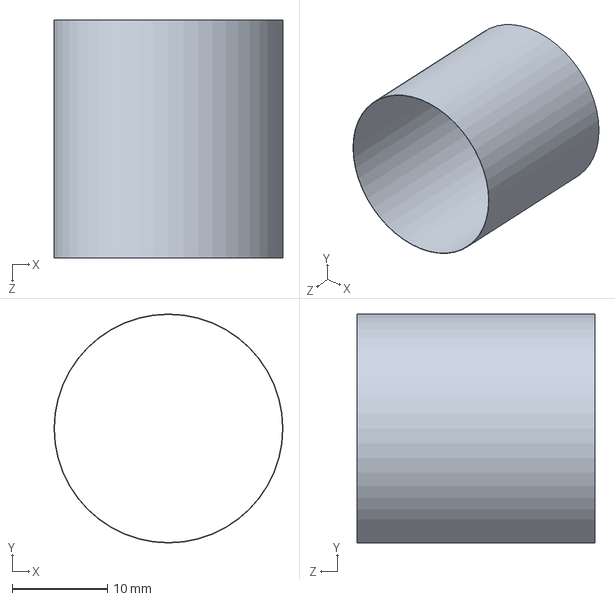
[picture p65: CAD file, 2017-05-07]
Simulation/EMS SW/tape5.SLDPRT
24.1 x 24.1 x 25.0 mm
