PnMagalhaes/Levitation-Ball/Simulation/EMS SW/copper2.SLDPRT

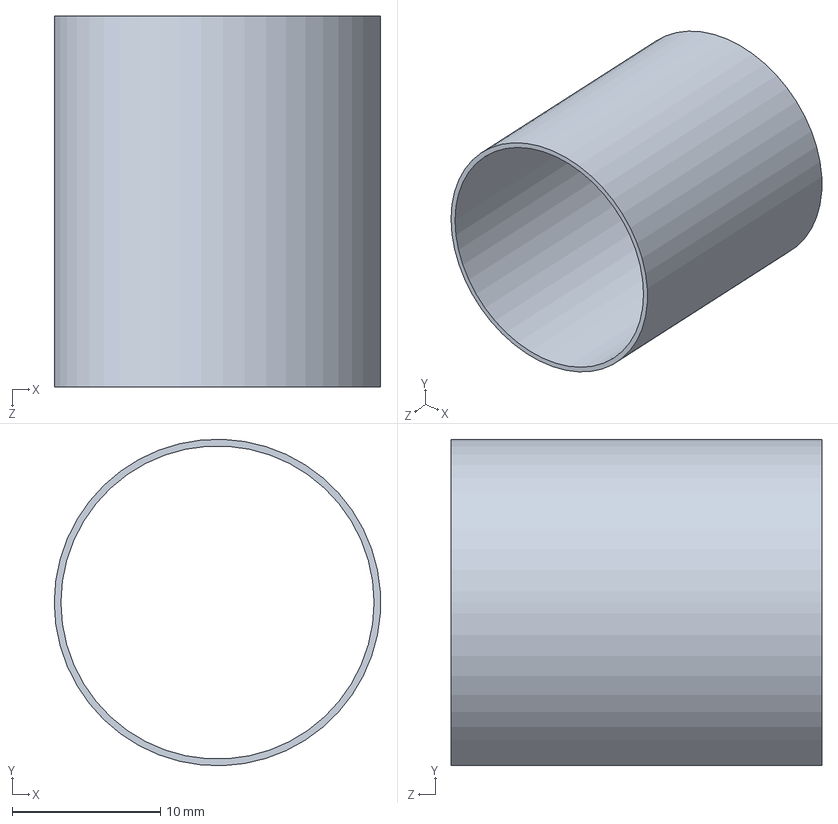
[picture p66: CAD file, 2017-05-07]
Simulation/EMS SW/copper2.SLDPRT
22.0 x 22.0 x 25.0 mm
