PnMagalhaes/Levitation-Ball/Simulation/EMS SW/copper1.SLDPRT

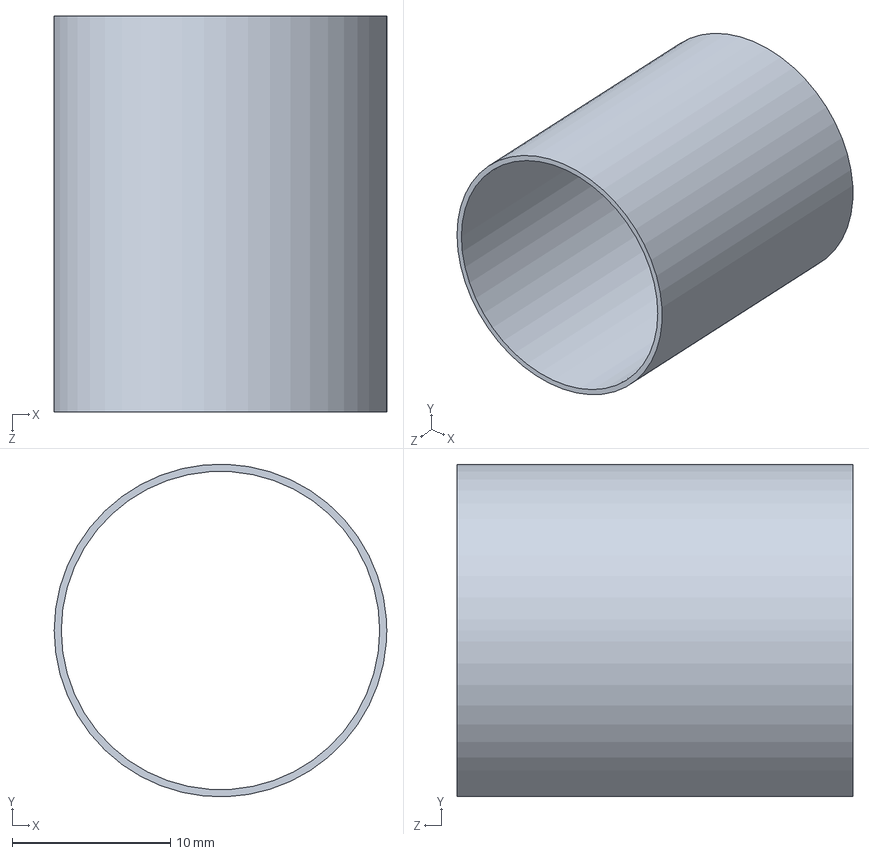
[picture p67: CAD file, 2017-05-07]
Simulation/EMS SW/copper1.SLDPRT
21.0 x 21.0 x 25.0 mm
