PnMagalhaes/Levitation-Ball/Simulation/EMS SW/pla.SLDPRT

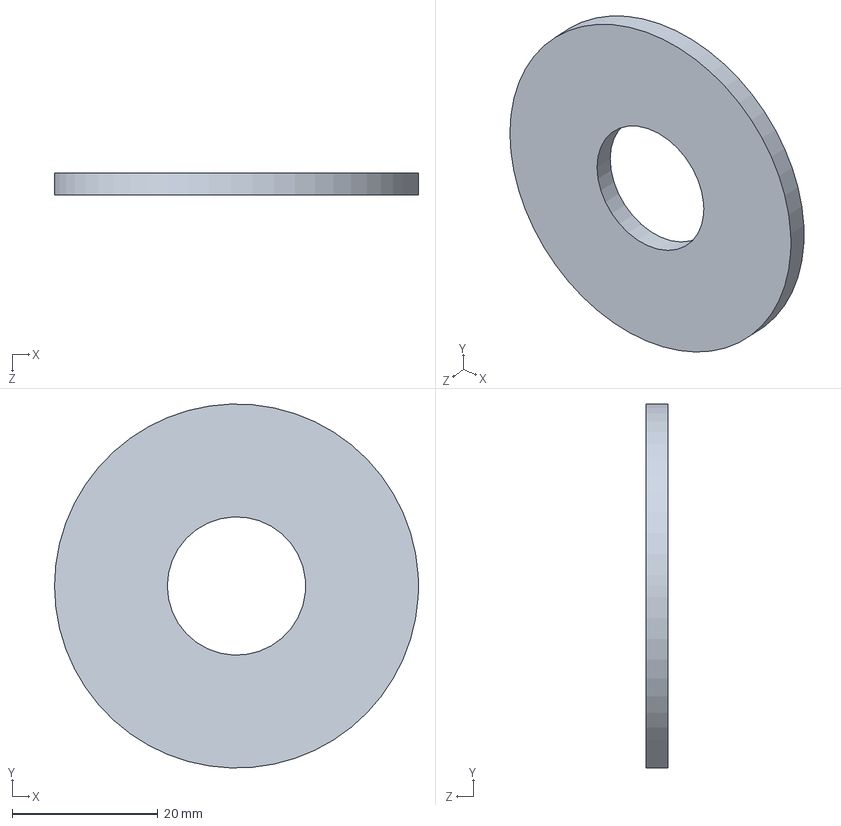
[picture p68: CAD file, 2017-05-07]
Simulation/EMS SW/pla.SLDPRT
50.0 x 50.0 x 3.00 mm
