PnMagalhaes/Levitation-Ball/Simulation/EMS SW/tape7.SLDPRT

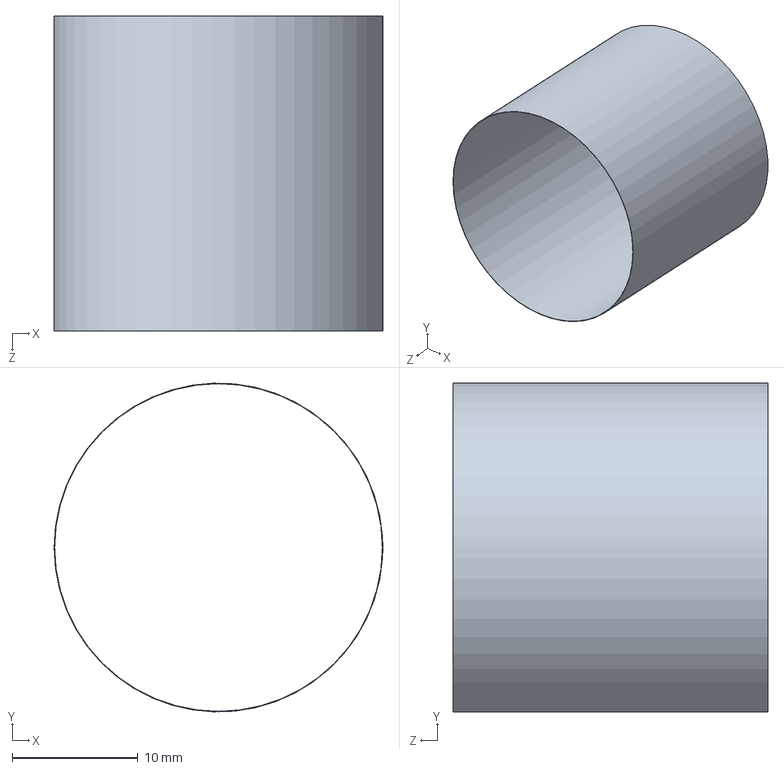
[picture p69: CAD file, 2017-05-07]
Simulation/EMS SW/tape7.SLDPRT
26.1 x 26.1 x 25.0 mm
