PnMagalhaes/Levitation-Ball/Simulation/EMS SW/copper10.SLDPRT

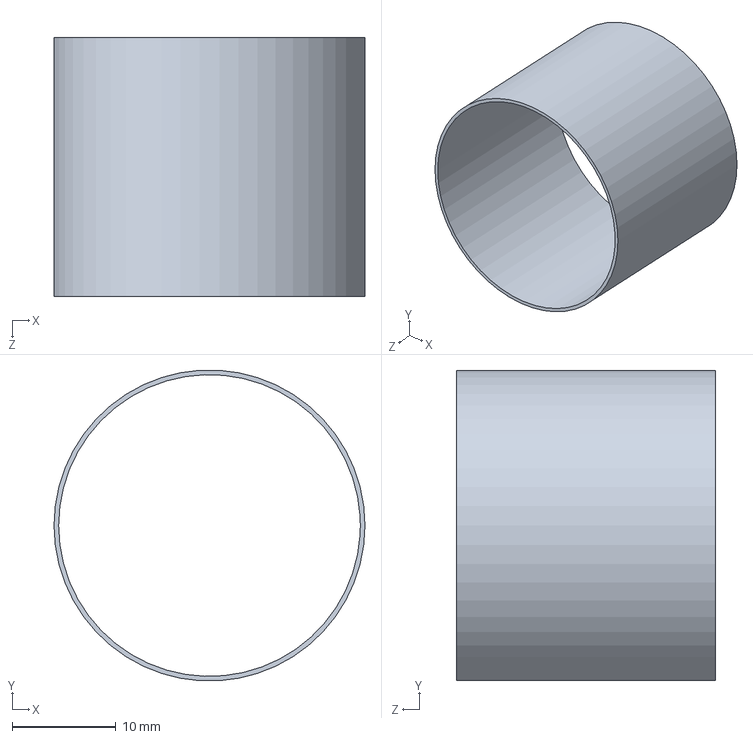
[picture p70: CAD file, 2017-05-07]
Simulation/EMS SW/copper10.SLDPRT
30.0 x 29.9 x 25.0 mm
