PnMagalhaes/Levitation-Ball/Simulation/EMS SW/Nucleo.SLDPRT

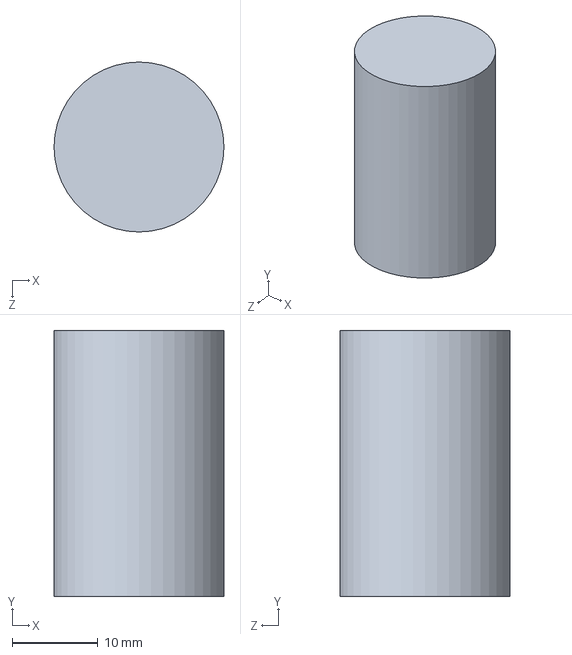
[picture p71: CAD file, 2017-05-07]
Simulation/EMS SW/Nucleo.SLDPRT
19.8 x 31.0 x 19.8 mm
