PnMagalhaes/Levitation-Ball/Simulation/EMS SW/tape8.SLDPRT

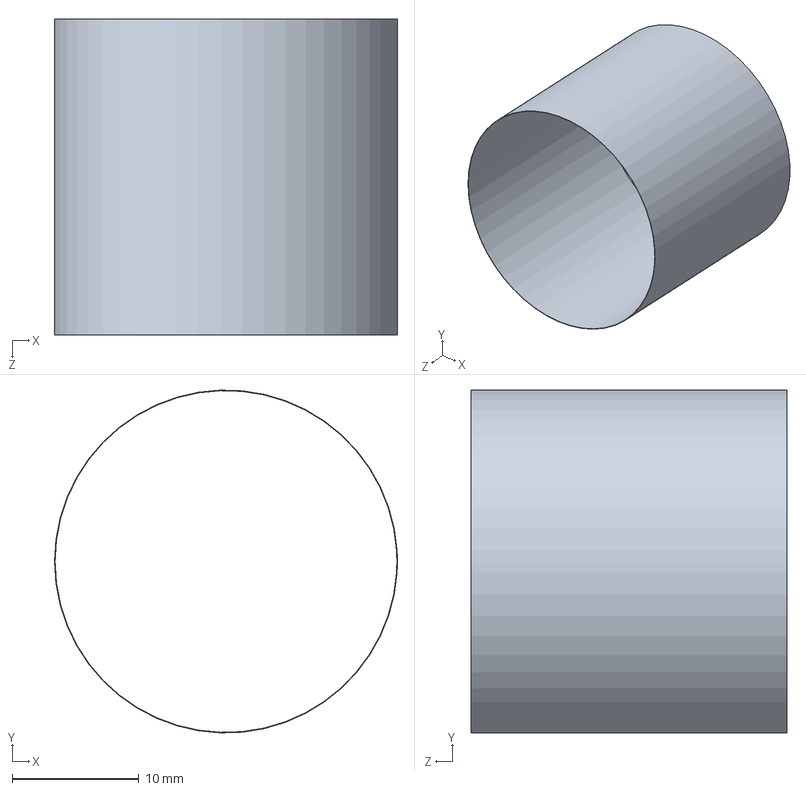
[picture p72: CAD file, 2017-05-07]
Simulation/EMS SW/tape8.SLDPRT
27.1 x 27.1 x 25.0 mm
