PnMagalhaes/Levitation-Ball/Simulation/EMS SW/outAir_cavity.SLDPRT

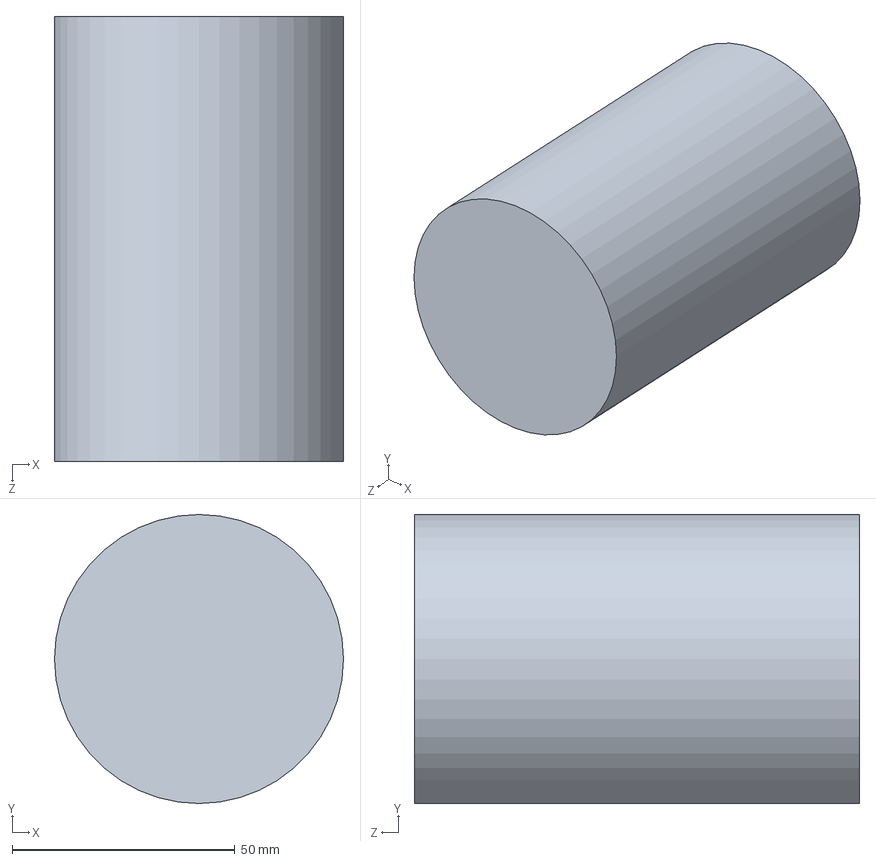
[picture p73: CAD file, 2017-05-07]
Simulation/EMS SW/outAir_cavity.SLDPRT
64.9 x 64.9 x 100.0 mm
