PnMagalhaes/Levitation-Ball/Simulation/EMS SW/dissipador.SLDPRT

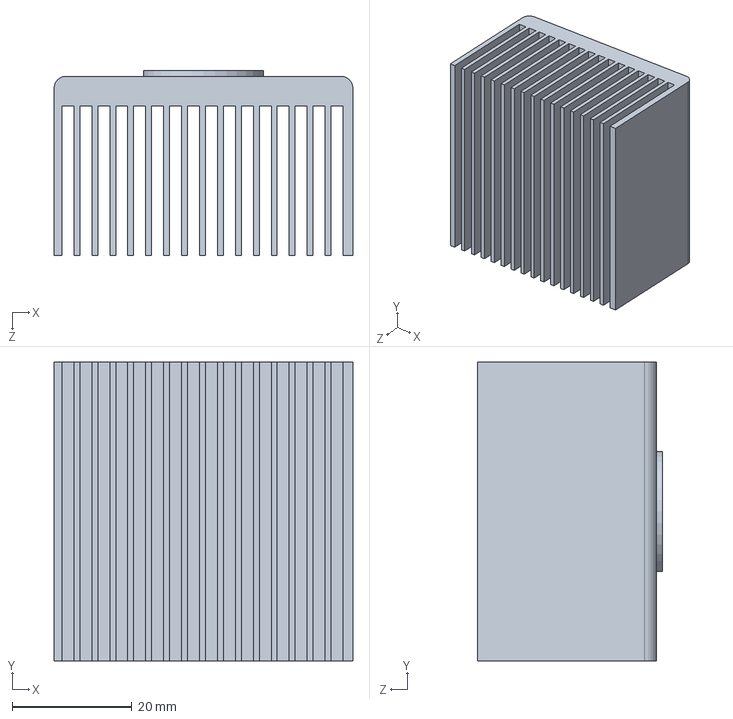
[picture p74: CAD file, 2017-05-07]
Simulation/EMS SW/dissipador.SLDPRT
50.0 x 50.0 x 31.0 mm
