PnMagalhaes/Levitation-Ball/Simulation/EMS SW/tape1.SLDPRT

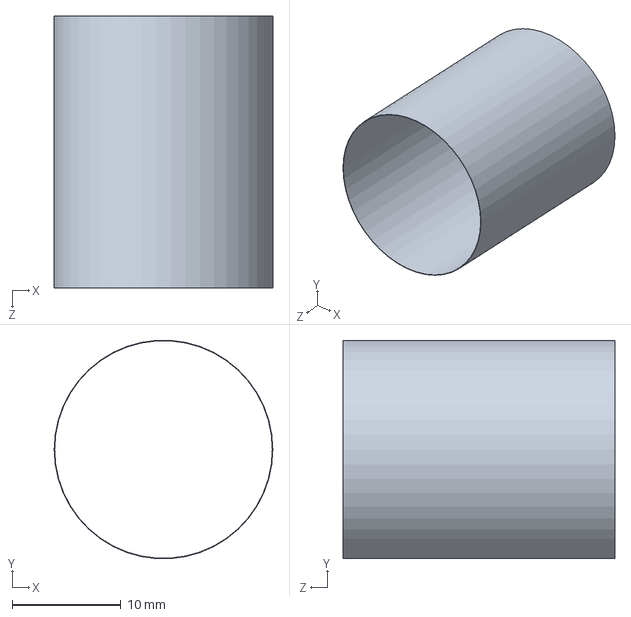
[picture p75: CAD file, 2017-05-07]
Simulation/EMS SW/tape1.SLDPRT
20.1 x 20.1 x 25.0 mm
