PnMagalhaes/Levitation-Ball/Simulation/EMS SW/tape3.SLDPRT

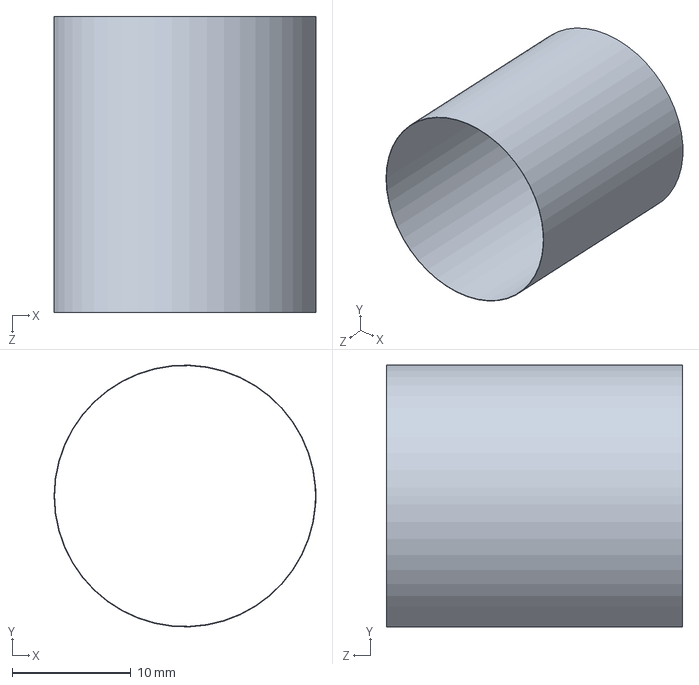
[picture p76: CAD file, 2017-05-07]
Simulation/EMS SW/tape3.SLDPRT
22.1 x 22.1 x 25.0 mm
