PnMagalhaes/Levitation-Ball/(list of files, cad)

Other CAD files:
Simulation/EMS SW/Assem1.SLDASM
3D models/STL-To print/anilha_baixo.SLDPRT
3D models/SolidWorks/top.SLDPRT
3D models/SolidWorks/fonte.SLDPRT
3D models/STL-To print/sensores2.STL
3D models/SolidWorks/Patinha.SLDPRT
Simulation/EMS SW/copper5.SLDPRT
Simulation/EMS SW/copper9.SLDPRT
Simulation/EMS SW/New folder/partbobina2.SLDPRT
Simulation/EMS SW/copper3.SLDPRT
Simulation/EMS SW/tape2.SLDPRT
Simulation/EMS SW/copper4.SLDPRT
Simulation/EMS SW/copper6.SLDPRT
Simulation/EMS SW/copper8.SLDPRT
Simulation/EMS SW/tape9.SLDPRT
3D models/STL-To print/anilha_baixo.STL
