PnMagalhaes/Levitation-Ball/Documentation/PERT Diagram Example 1.pdf

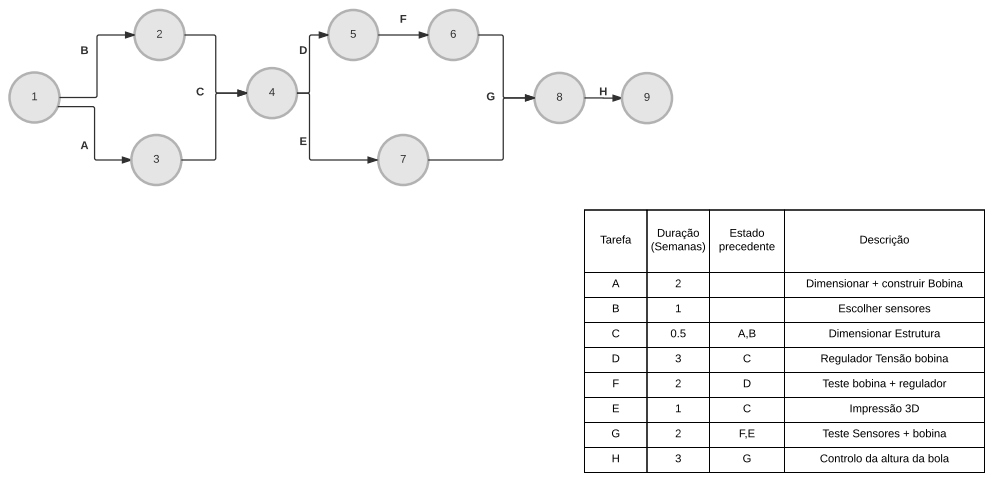
[picture p77: page 1]

Tarefa | Duração (Semanas) | Estado precedente | Descrição

A | 2 | | Dimensionar + construir Bobina
B | 1 | | Escolher sensores
C | 0.5 | A,B | Dimensionar Estrutura
D | 3 | C | Regulador Tensão bobina
F | 2 | D | Teste bobina + regulador
E | 1 | C | Impressão 3D
G | 2 | F,E | Teste Sensores + bobina
H | 3 | G | Controlo da altura da bola
