PnMagalhaes/Levitation-Ball/Galery/20170317_103118.jpg

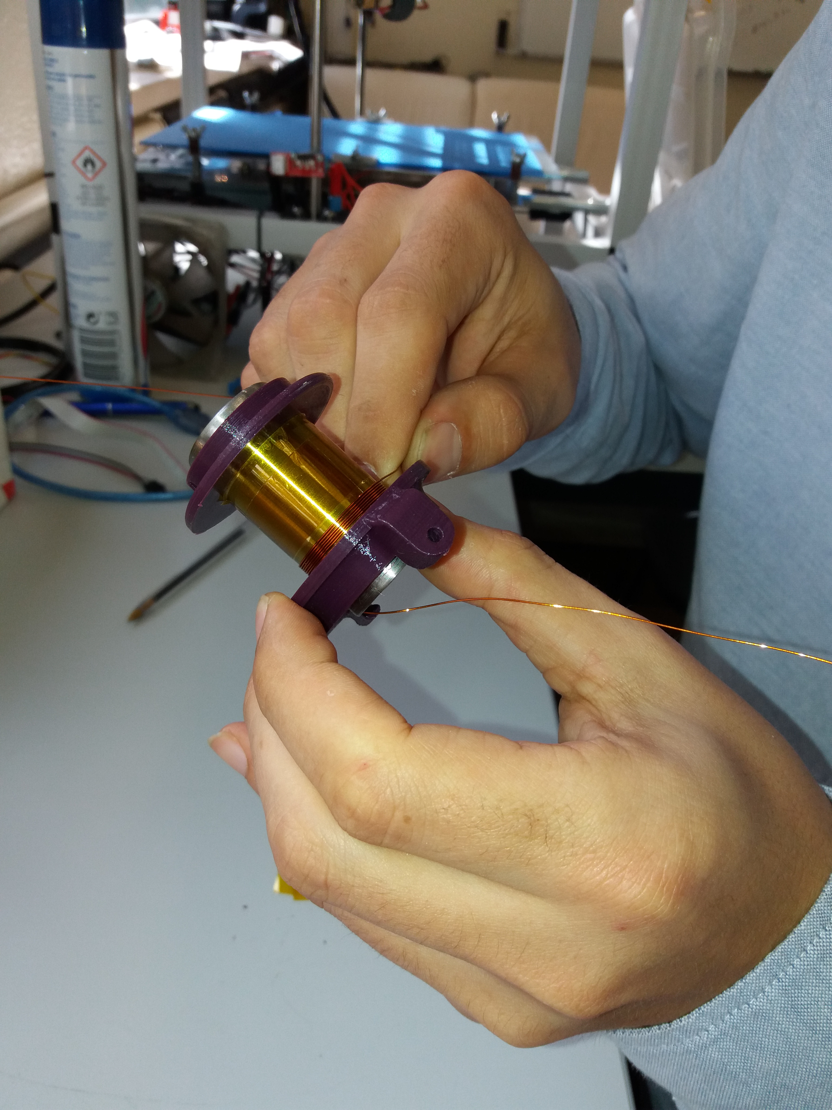
Galery/20170317_103118.jpg
