PnMagalhaes/Levitation-Ball/Galery/20170320_143547.jpg

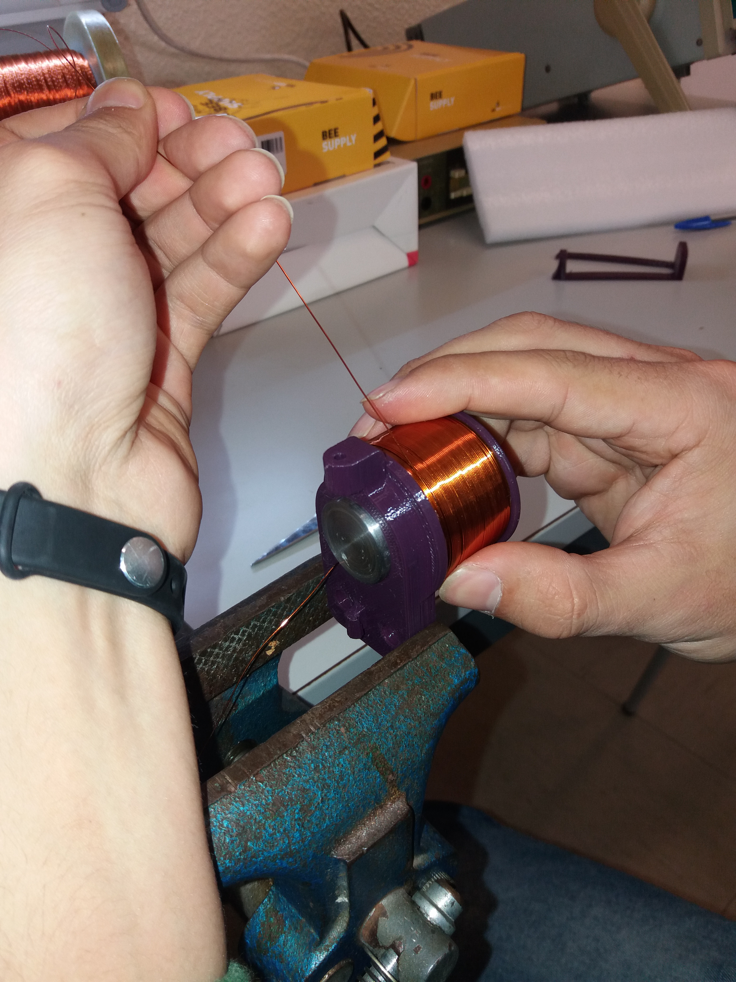
Galery/20170320_143547.jpg
