PnMagalhaes/Levitation-Ball/Galery/20170320_180022.jpg

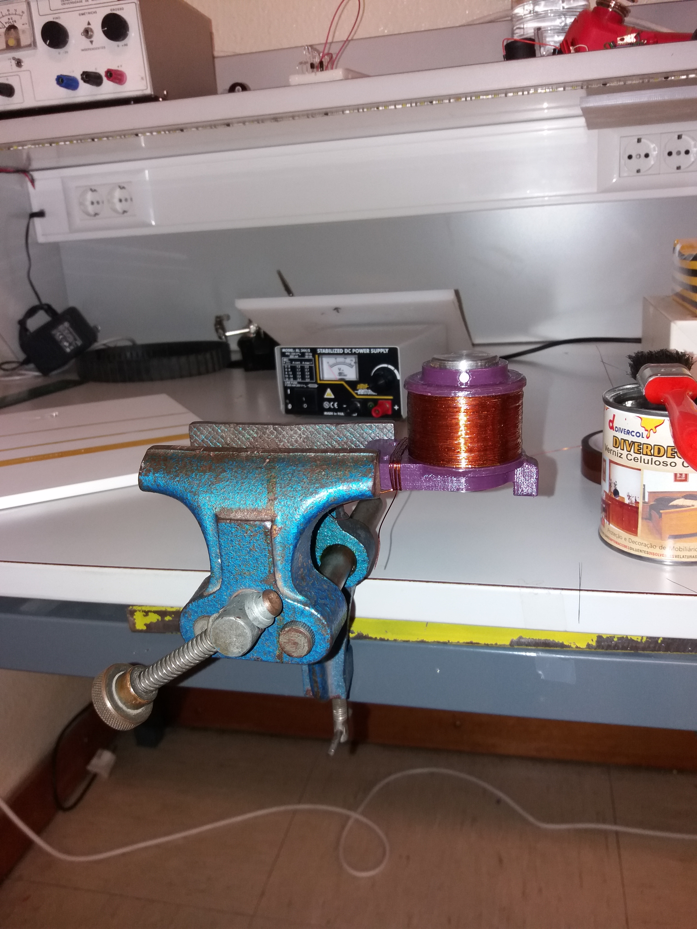
Galery/20170320_180022.jpg
